vacuumsens/Final/(list of files, cad)

Other CAD files:
Client/VacuumSens V4.step
