vacuumsens/Final/VSENS.pdf

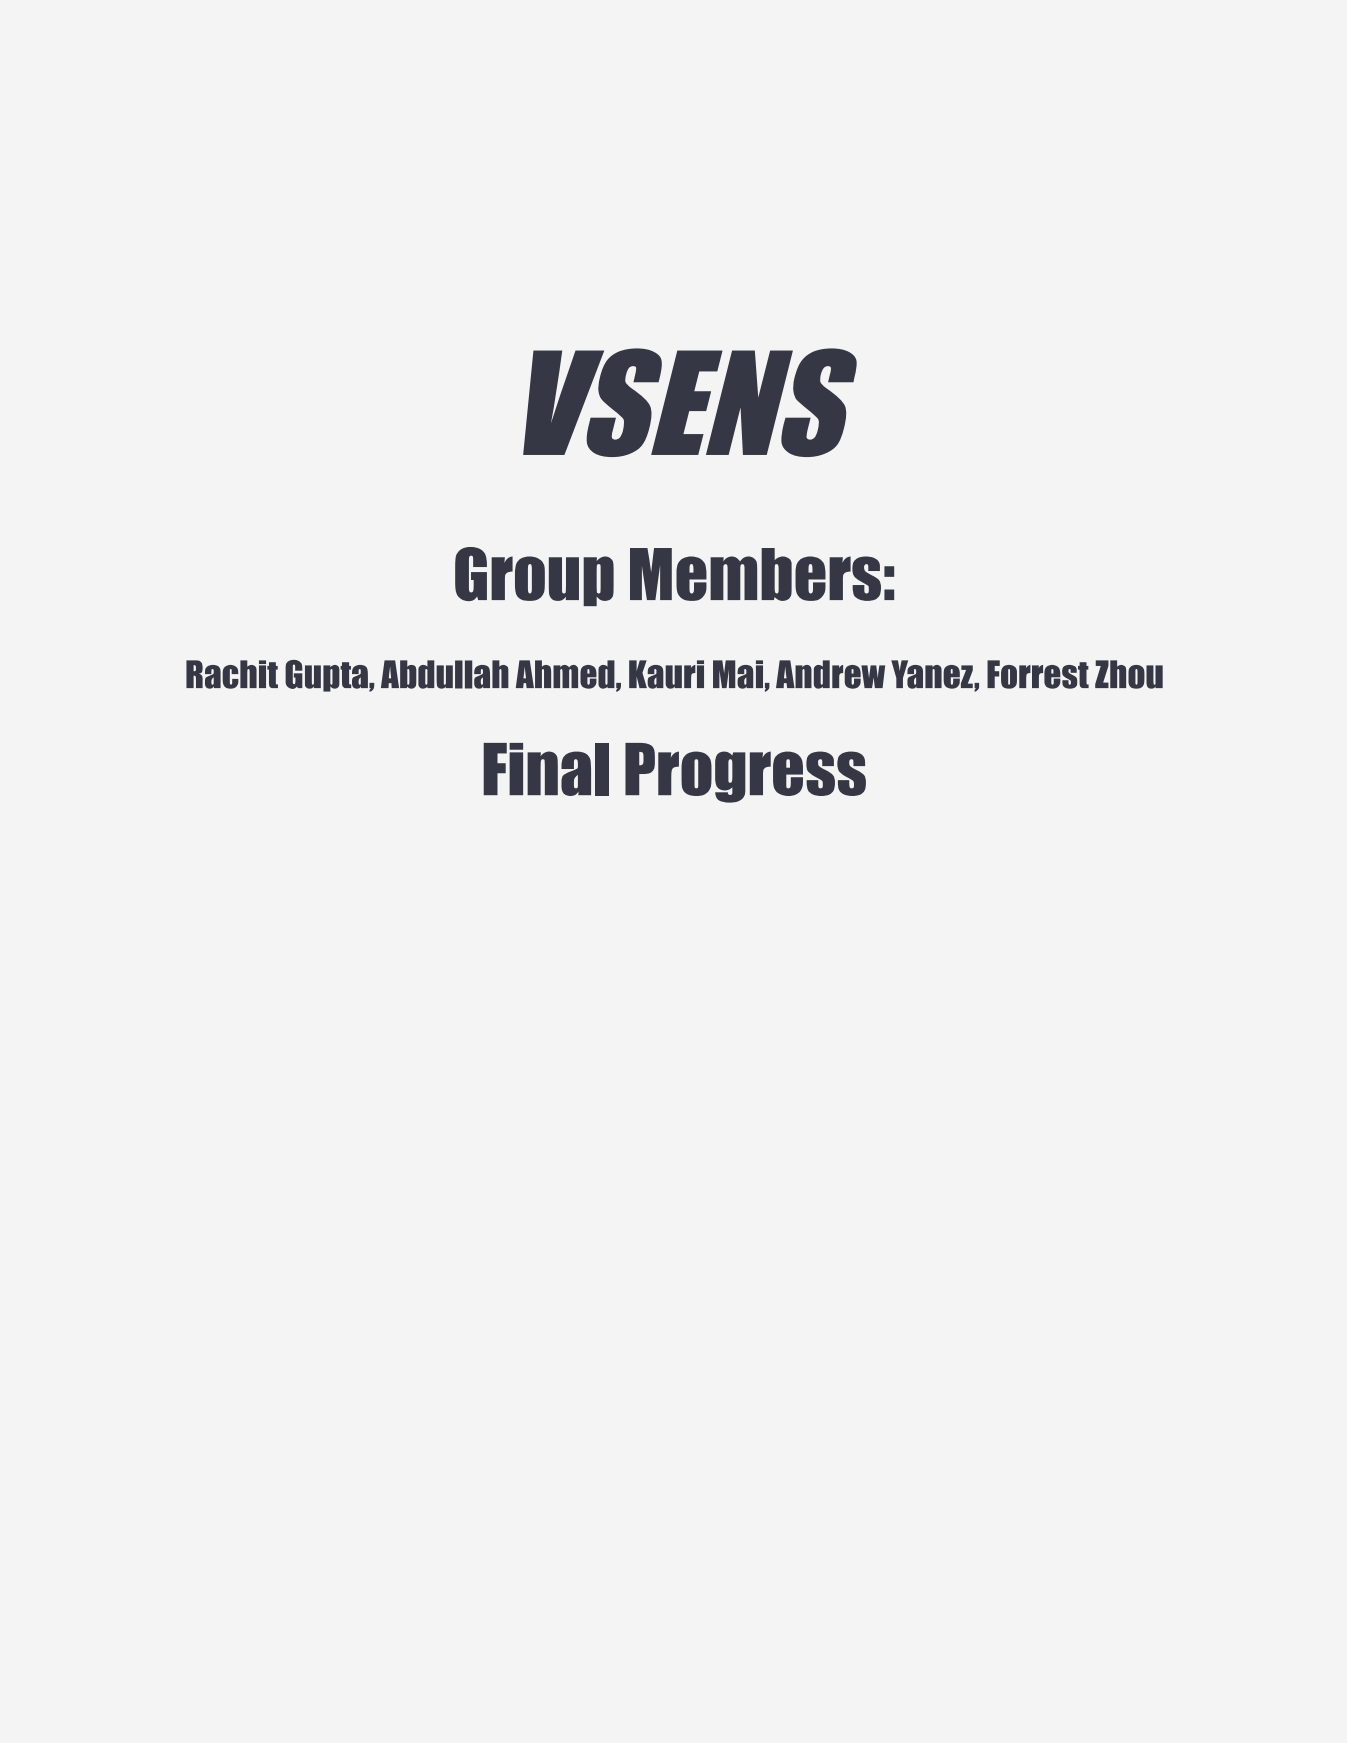
[picture p1: page 1]

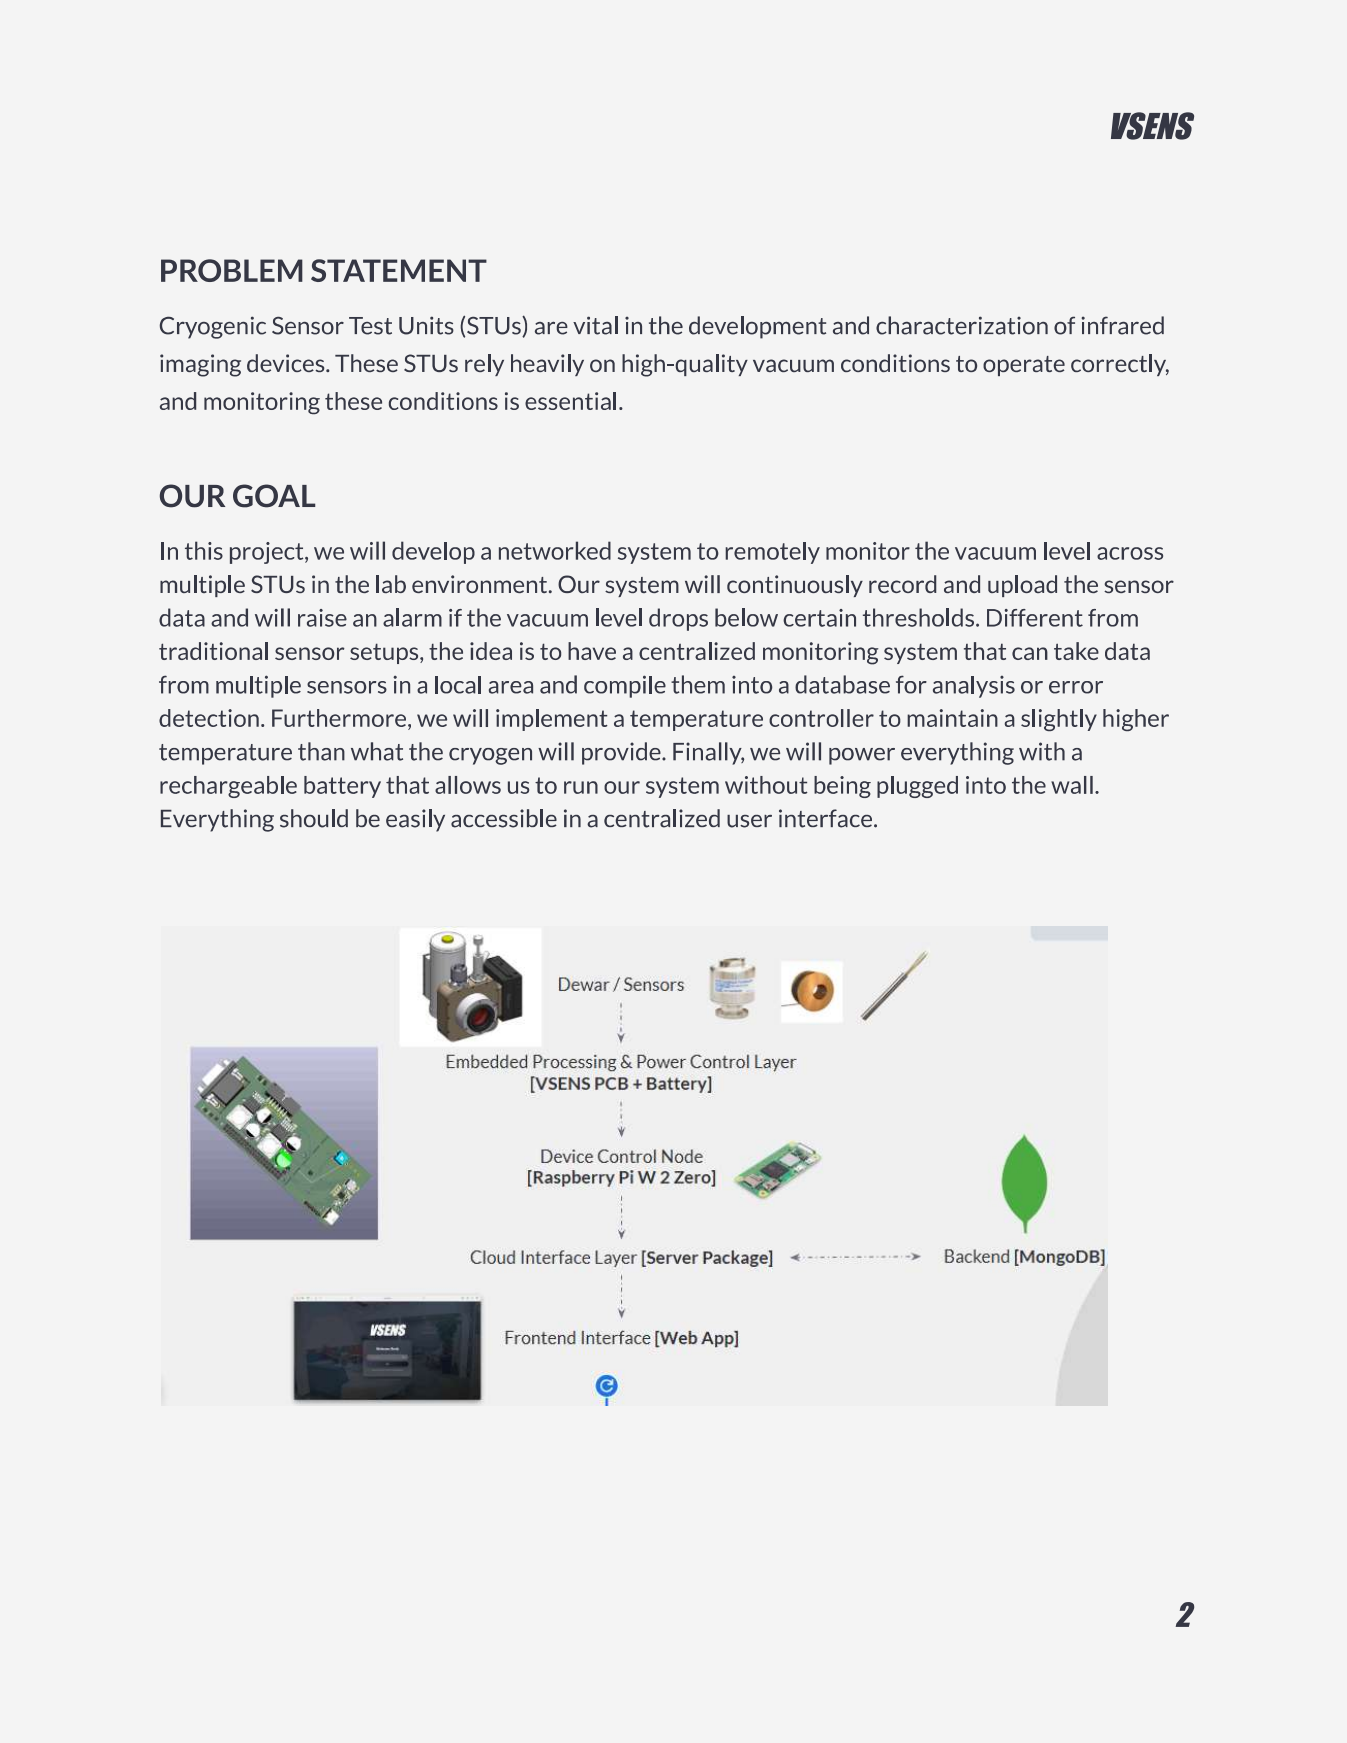
[picture p2: page 2]

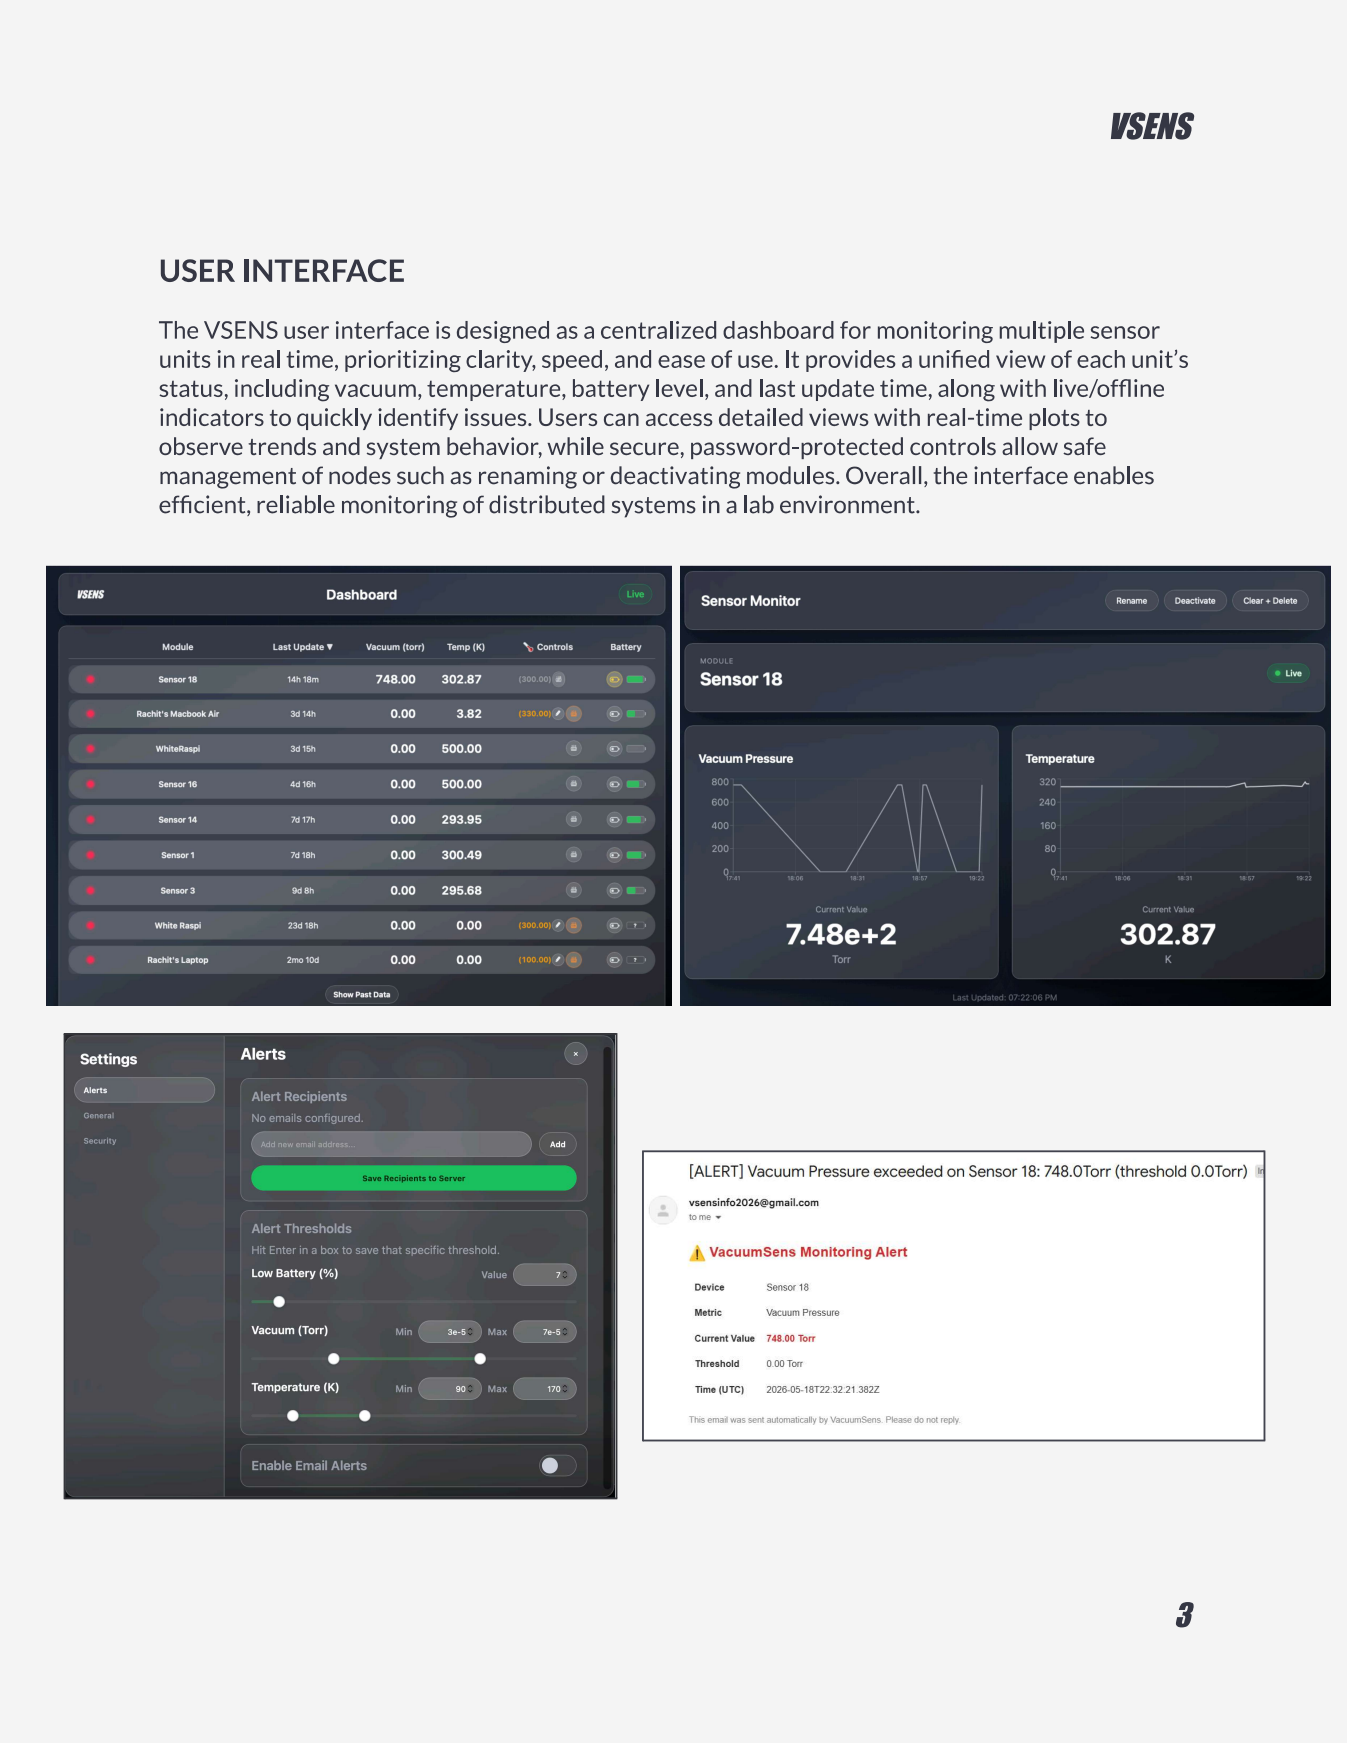
[picture p3: page 3]

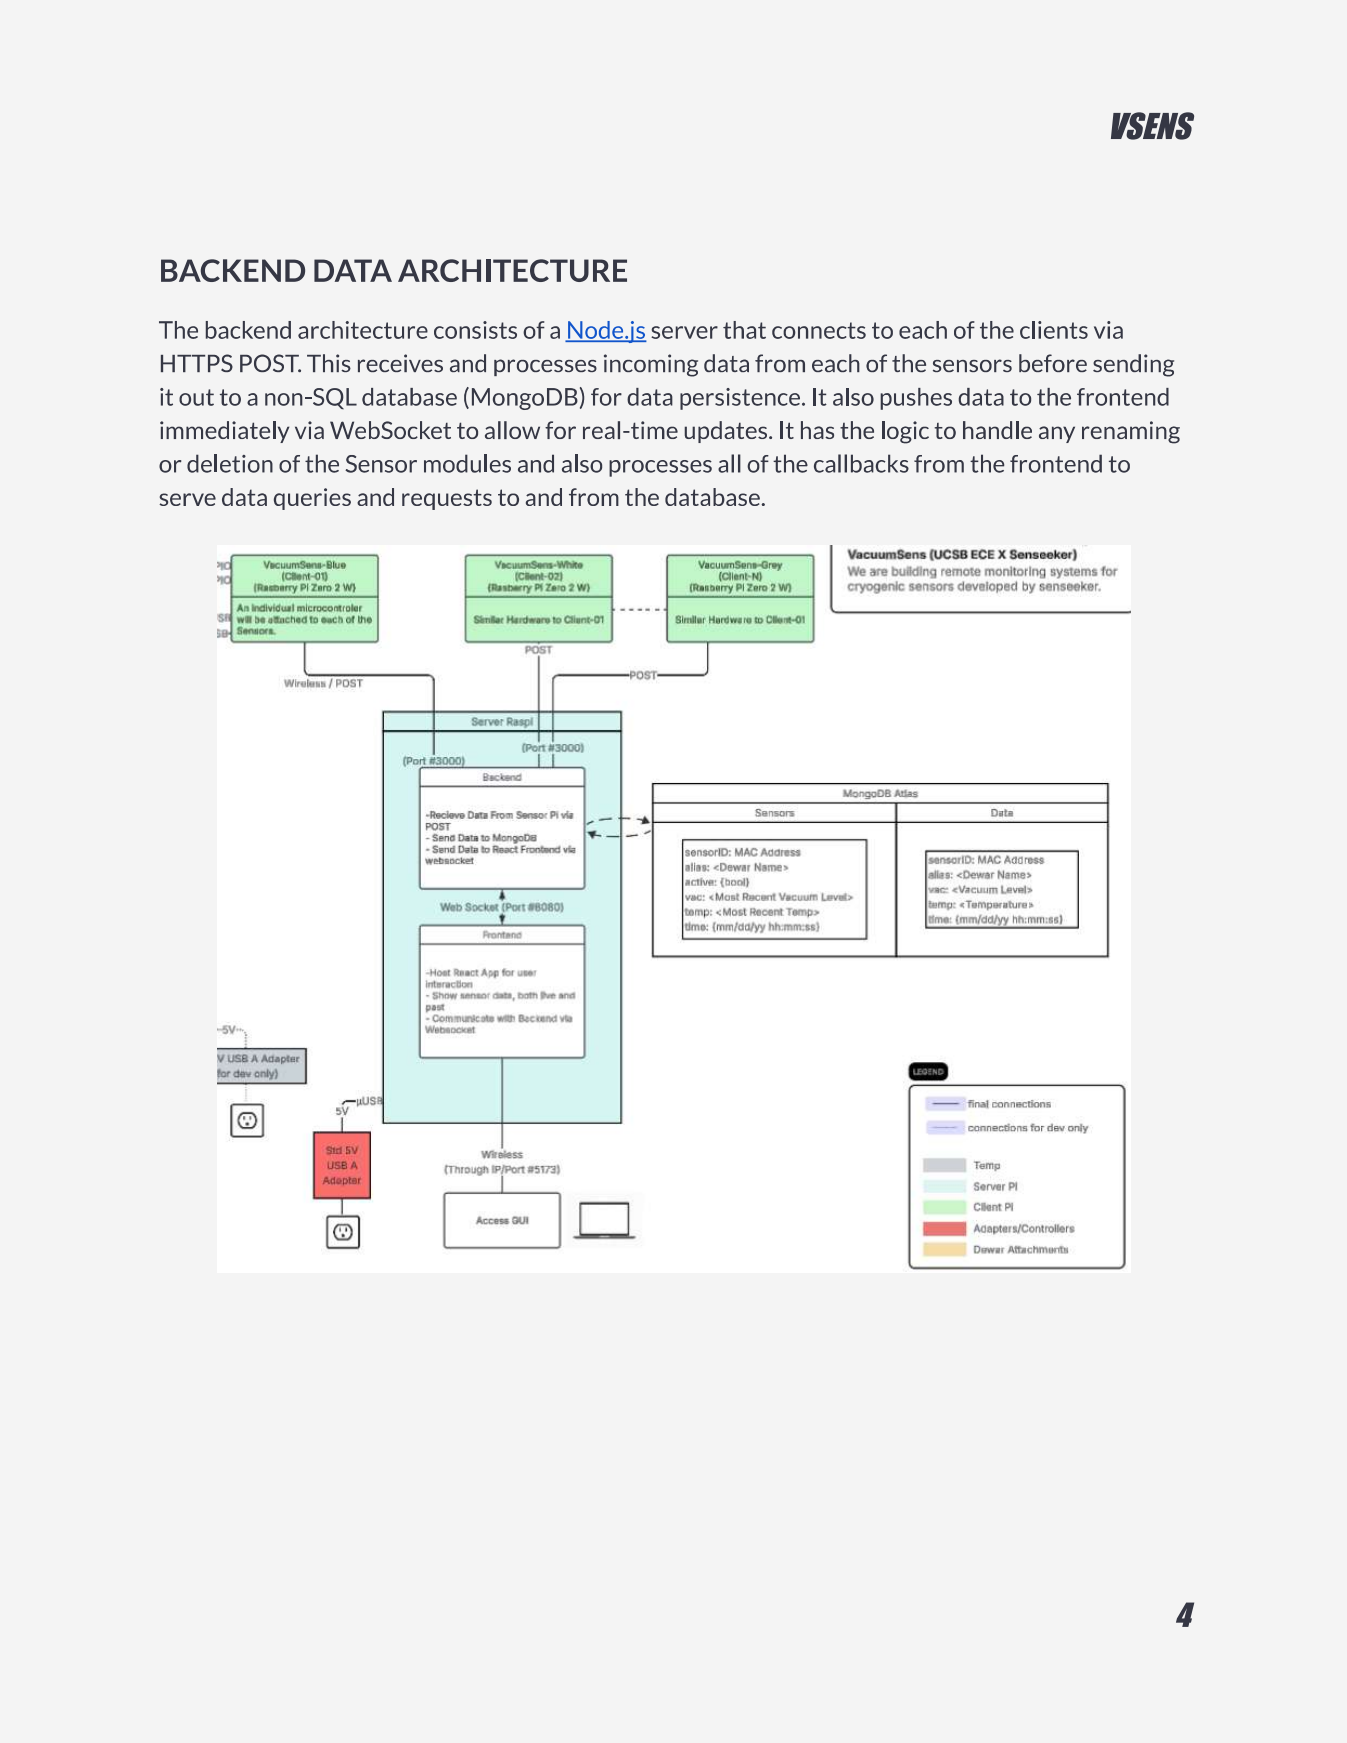
[picture p4: page 4]

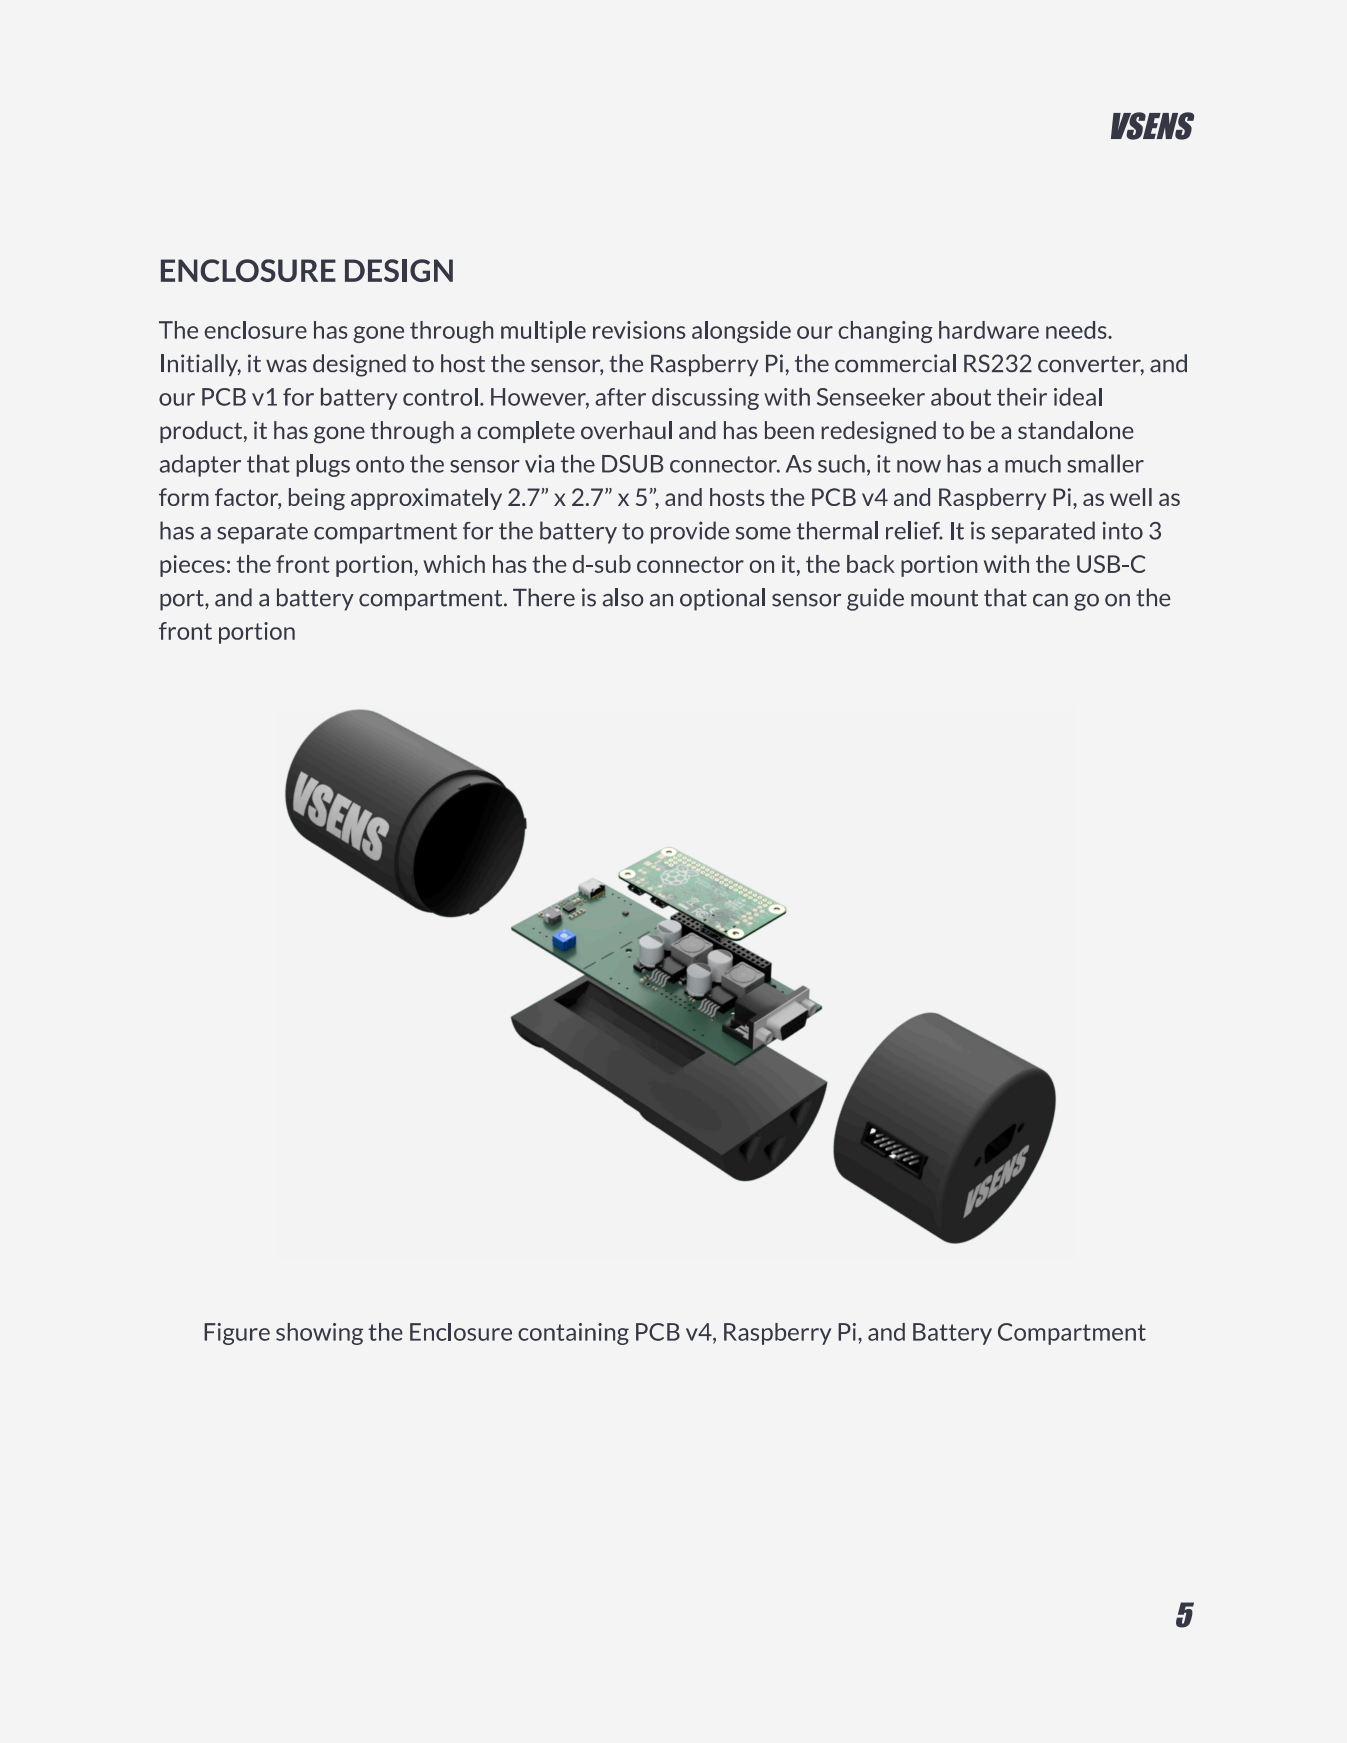
[picture p5: page 5]

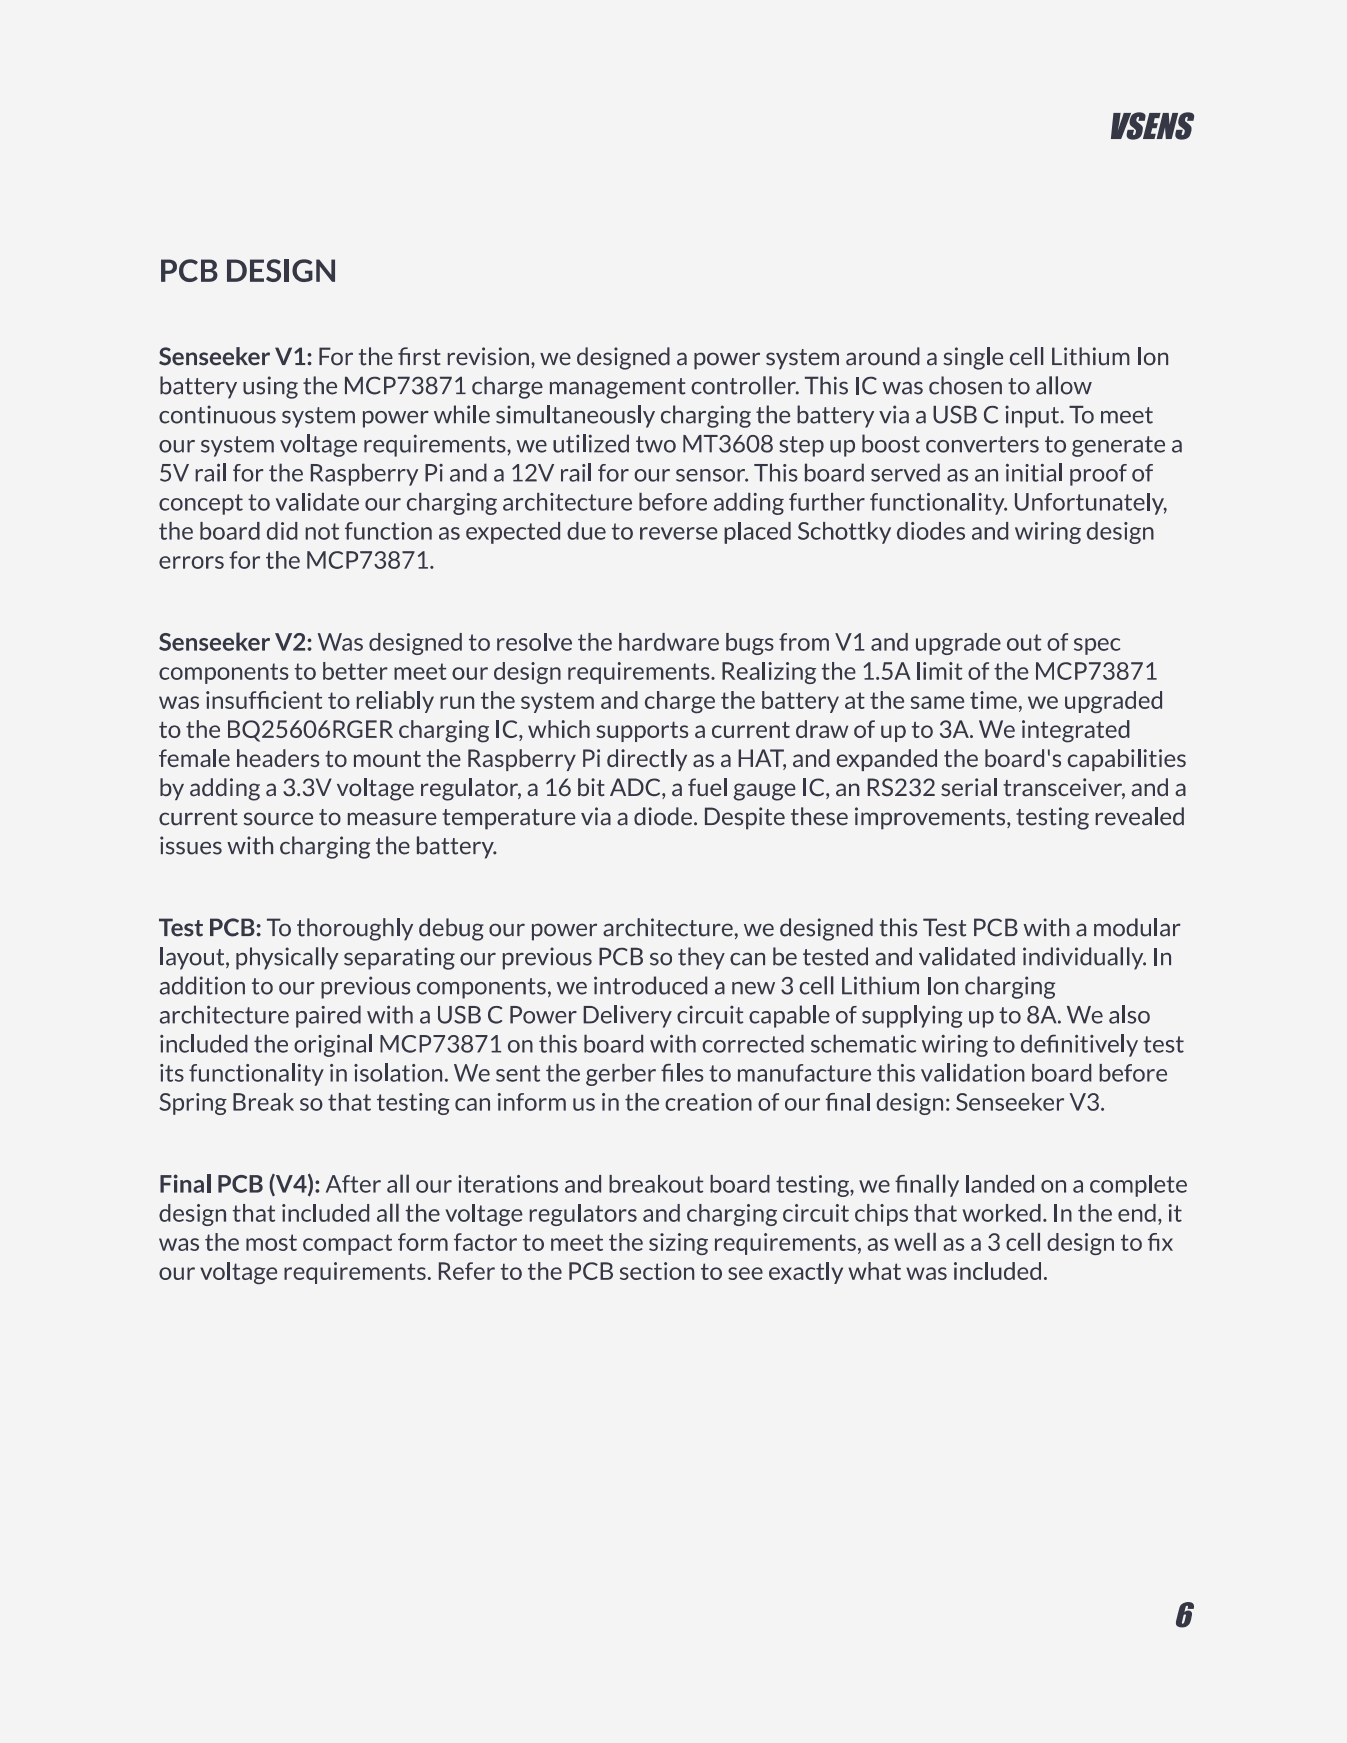
[picture p6: page 6]

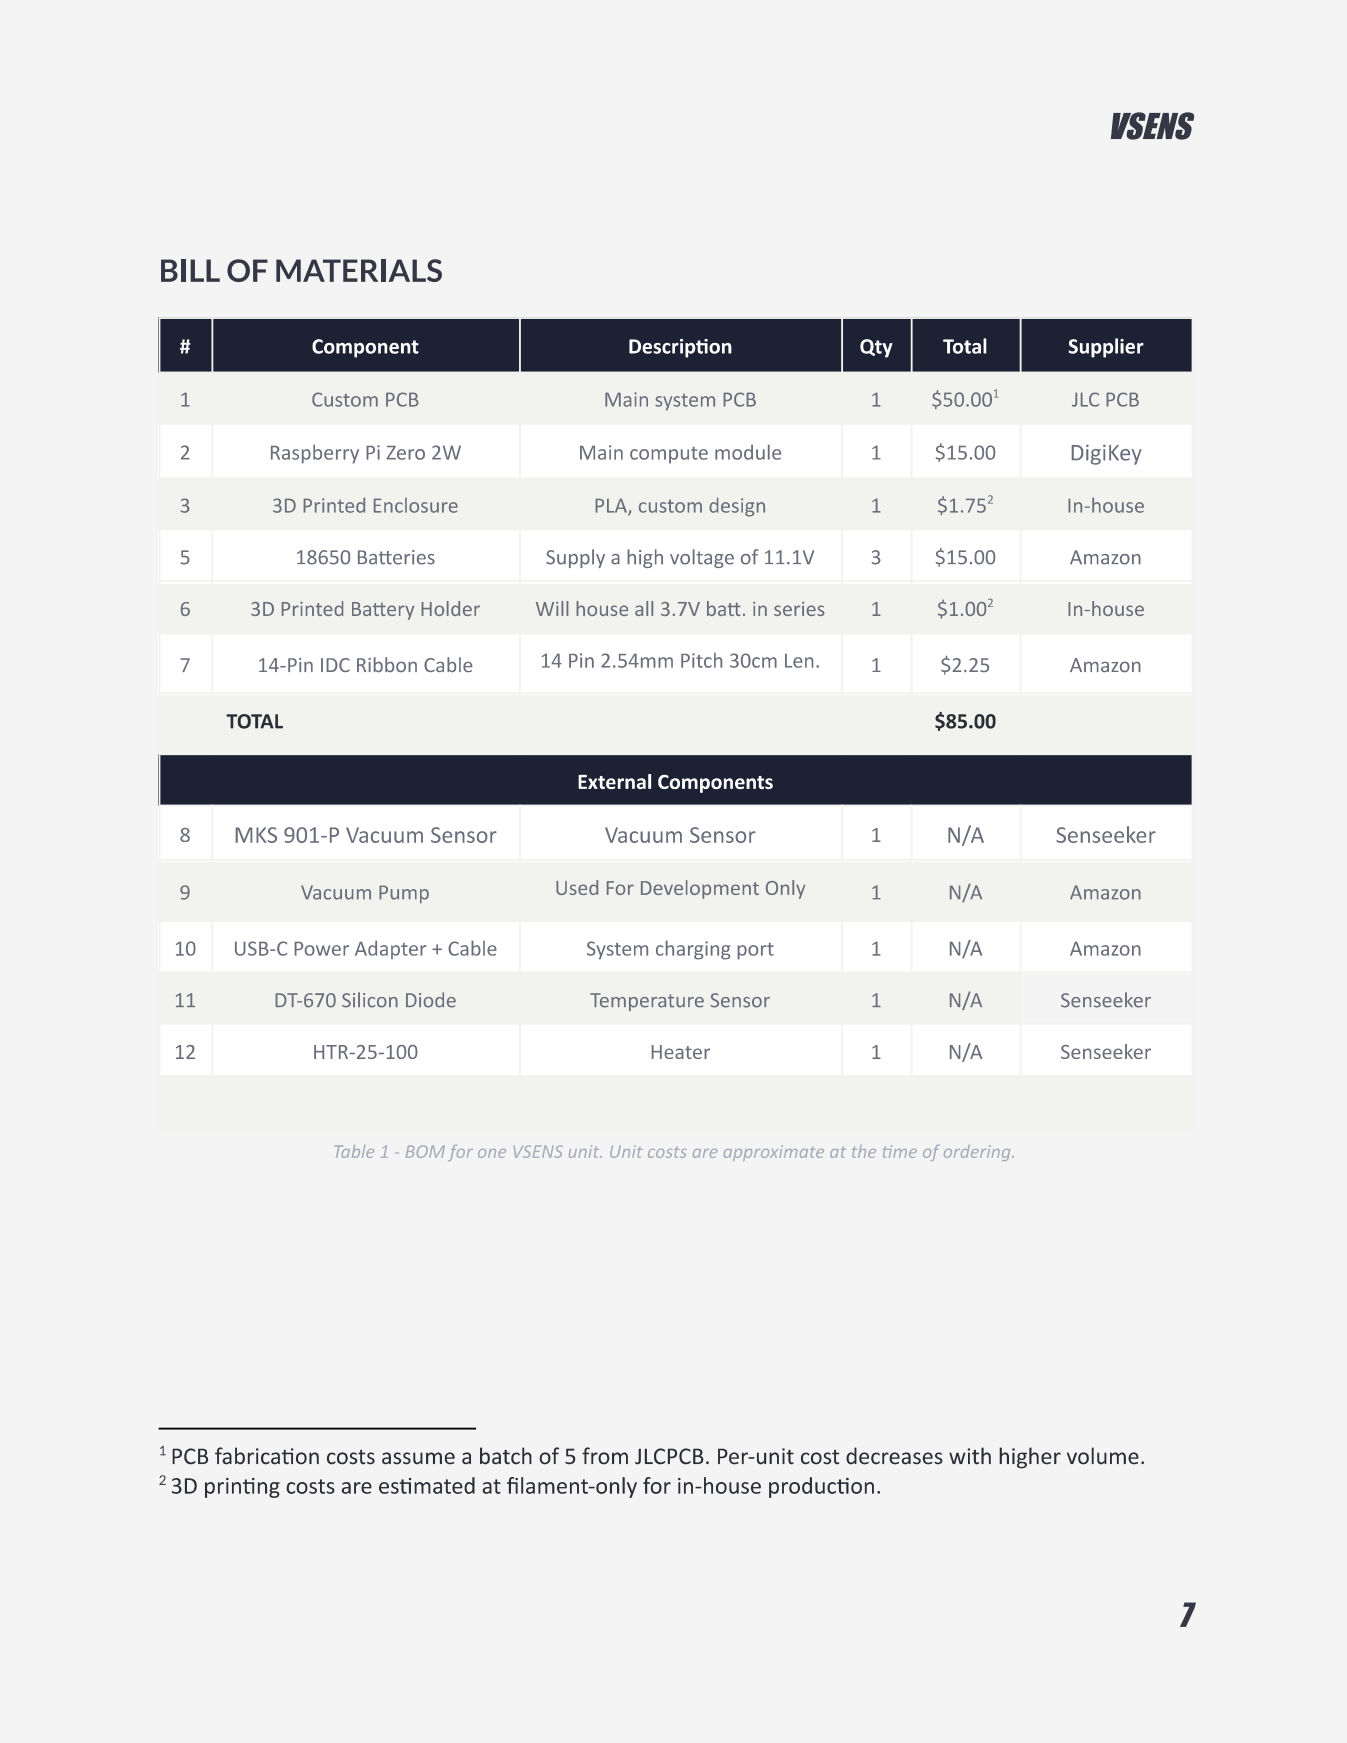
[picture p7: page 7]

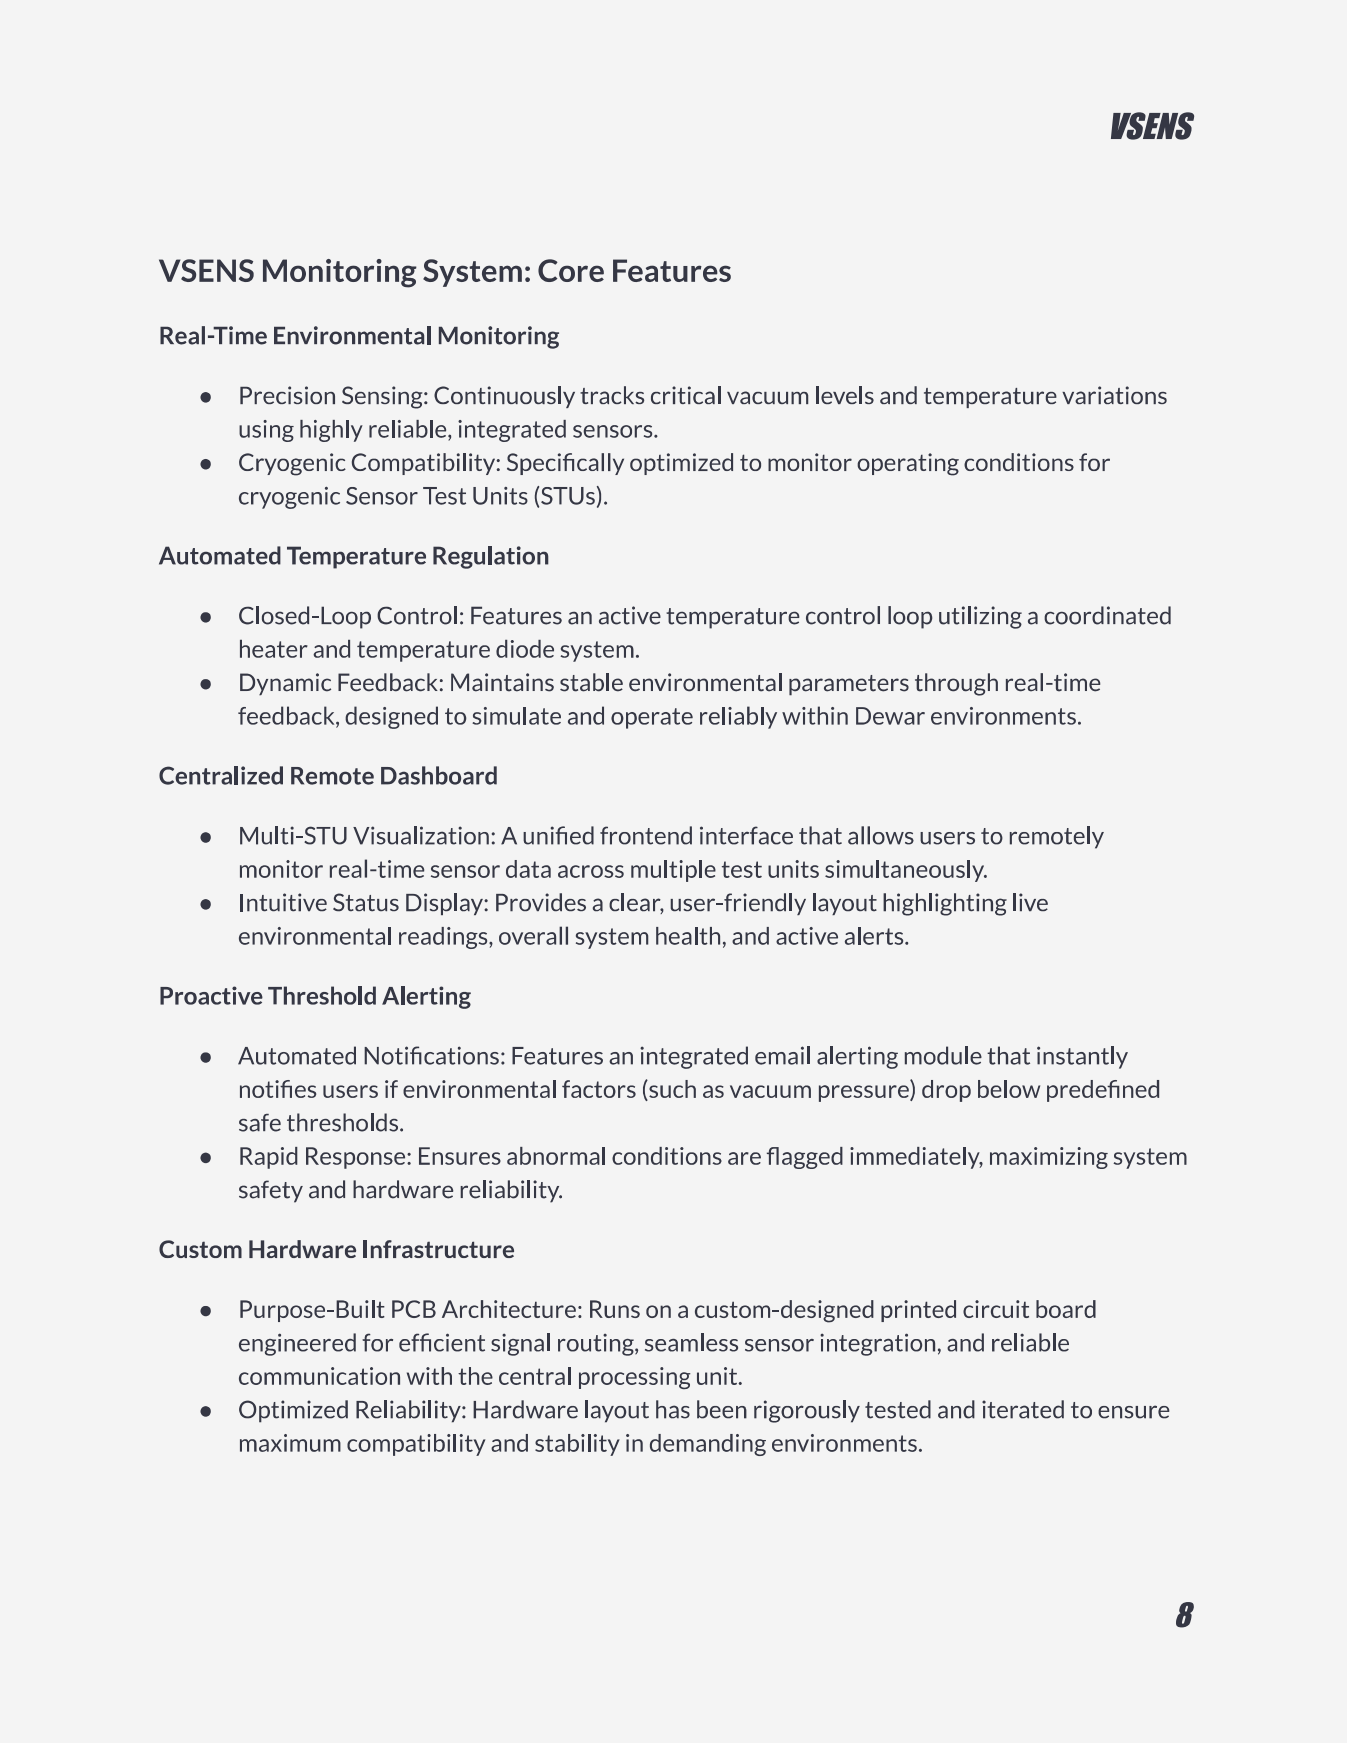
[picture p8: page 8]

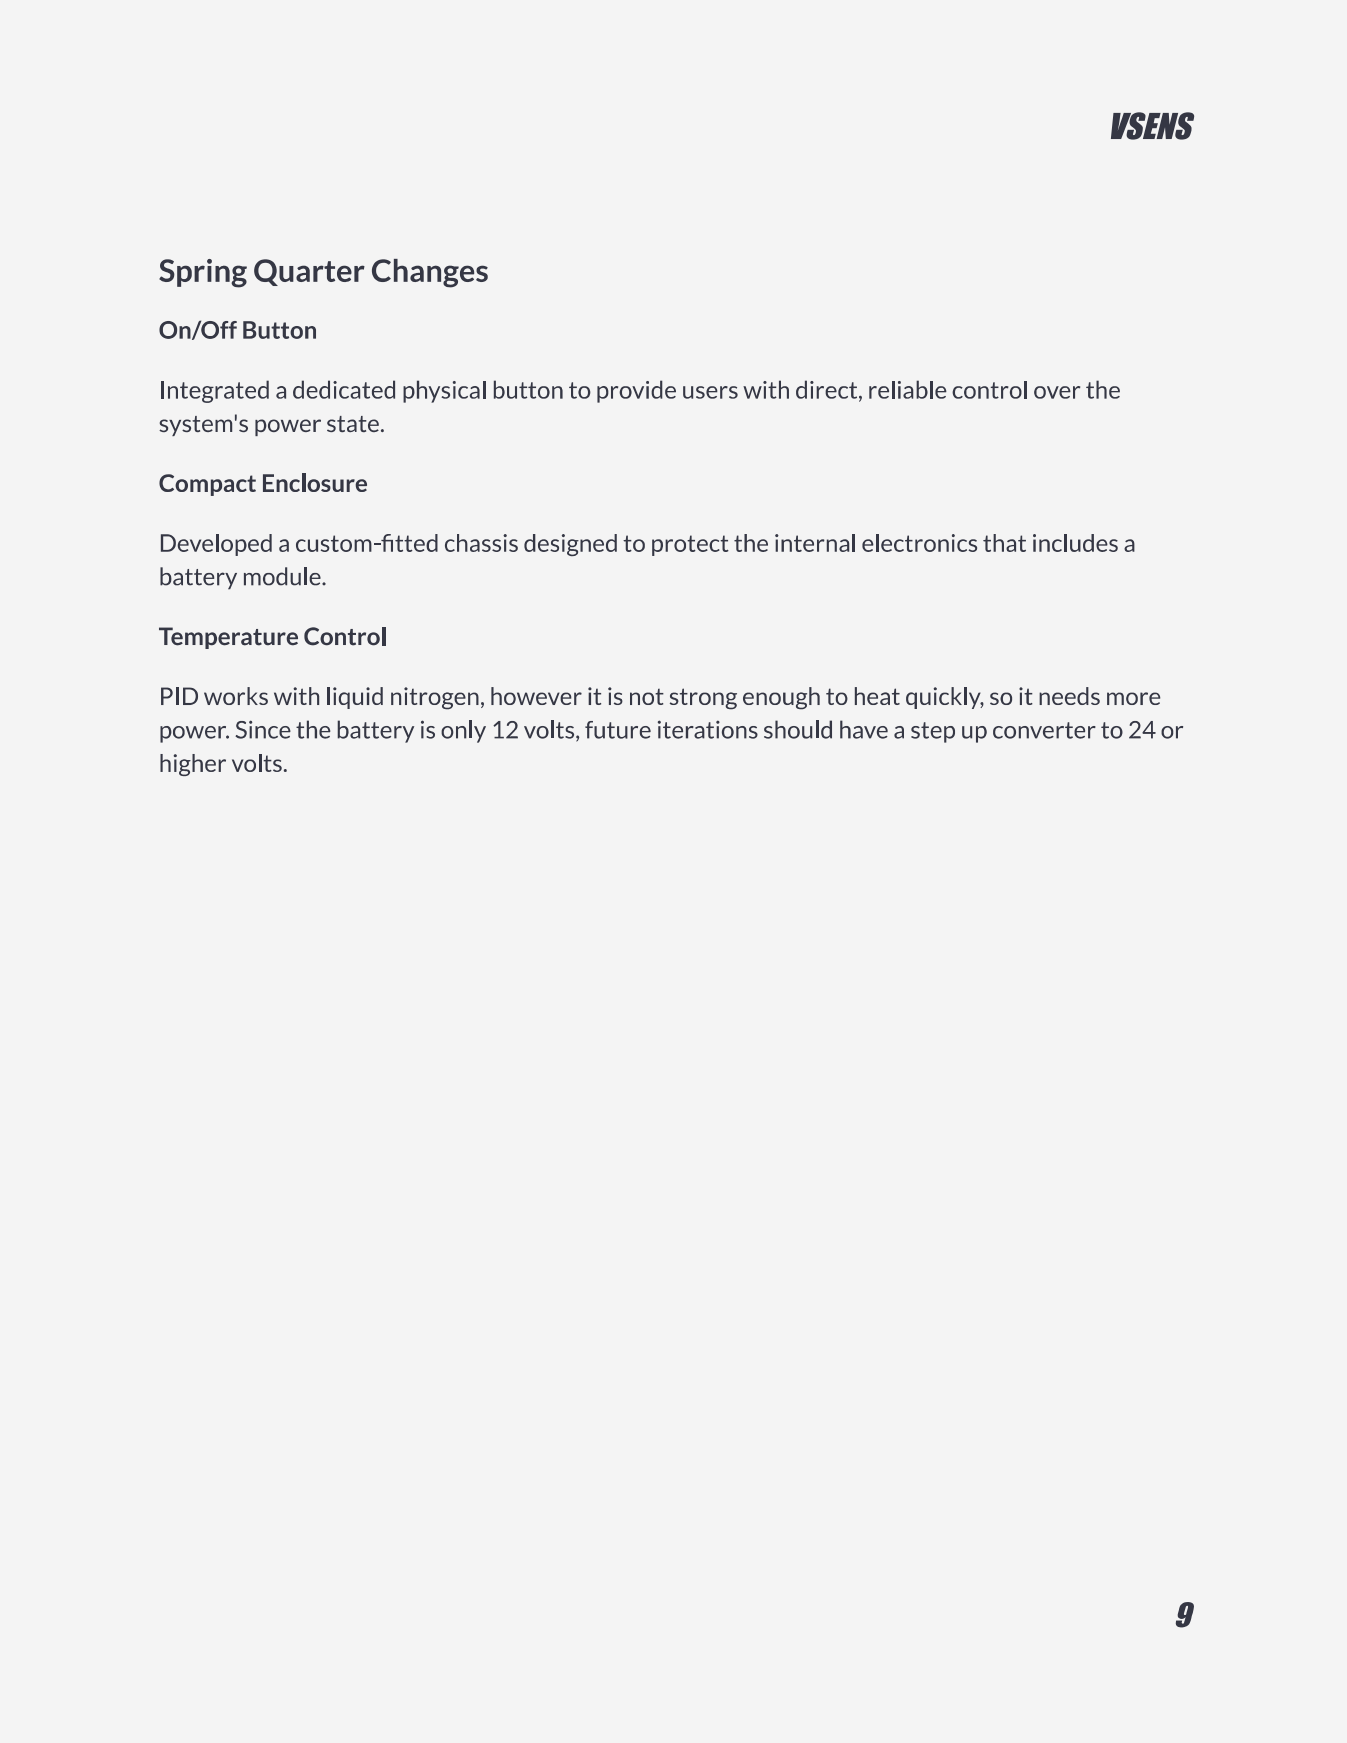
[picture p9: page 9]

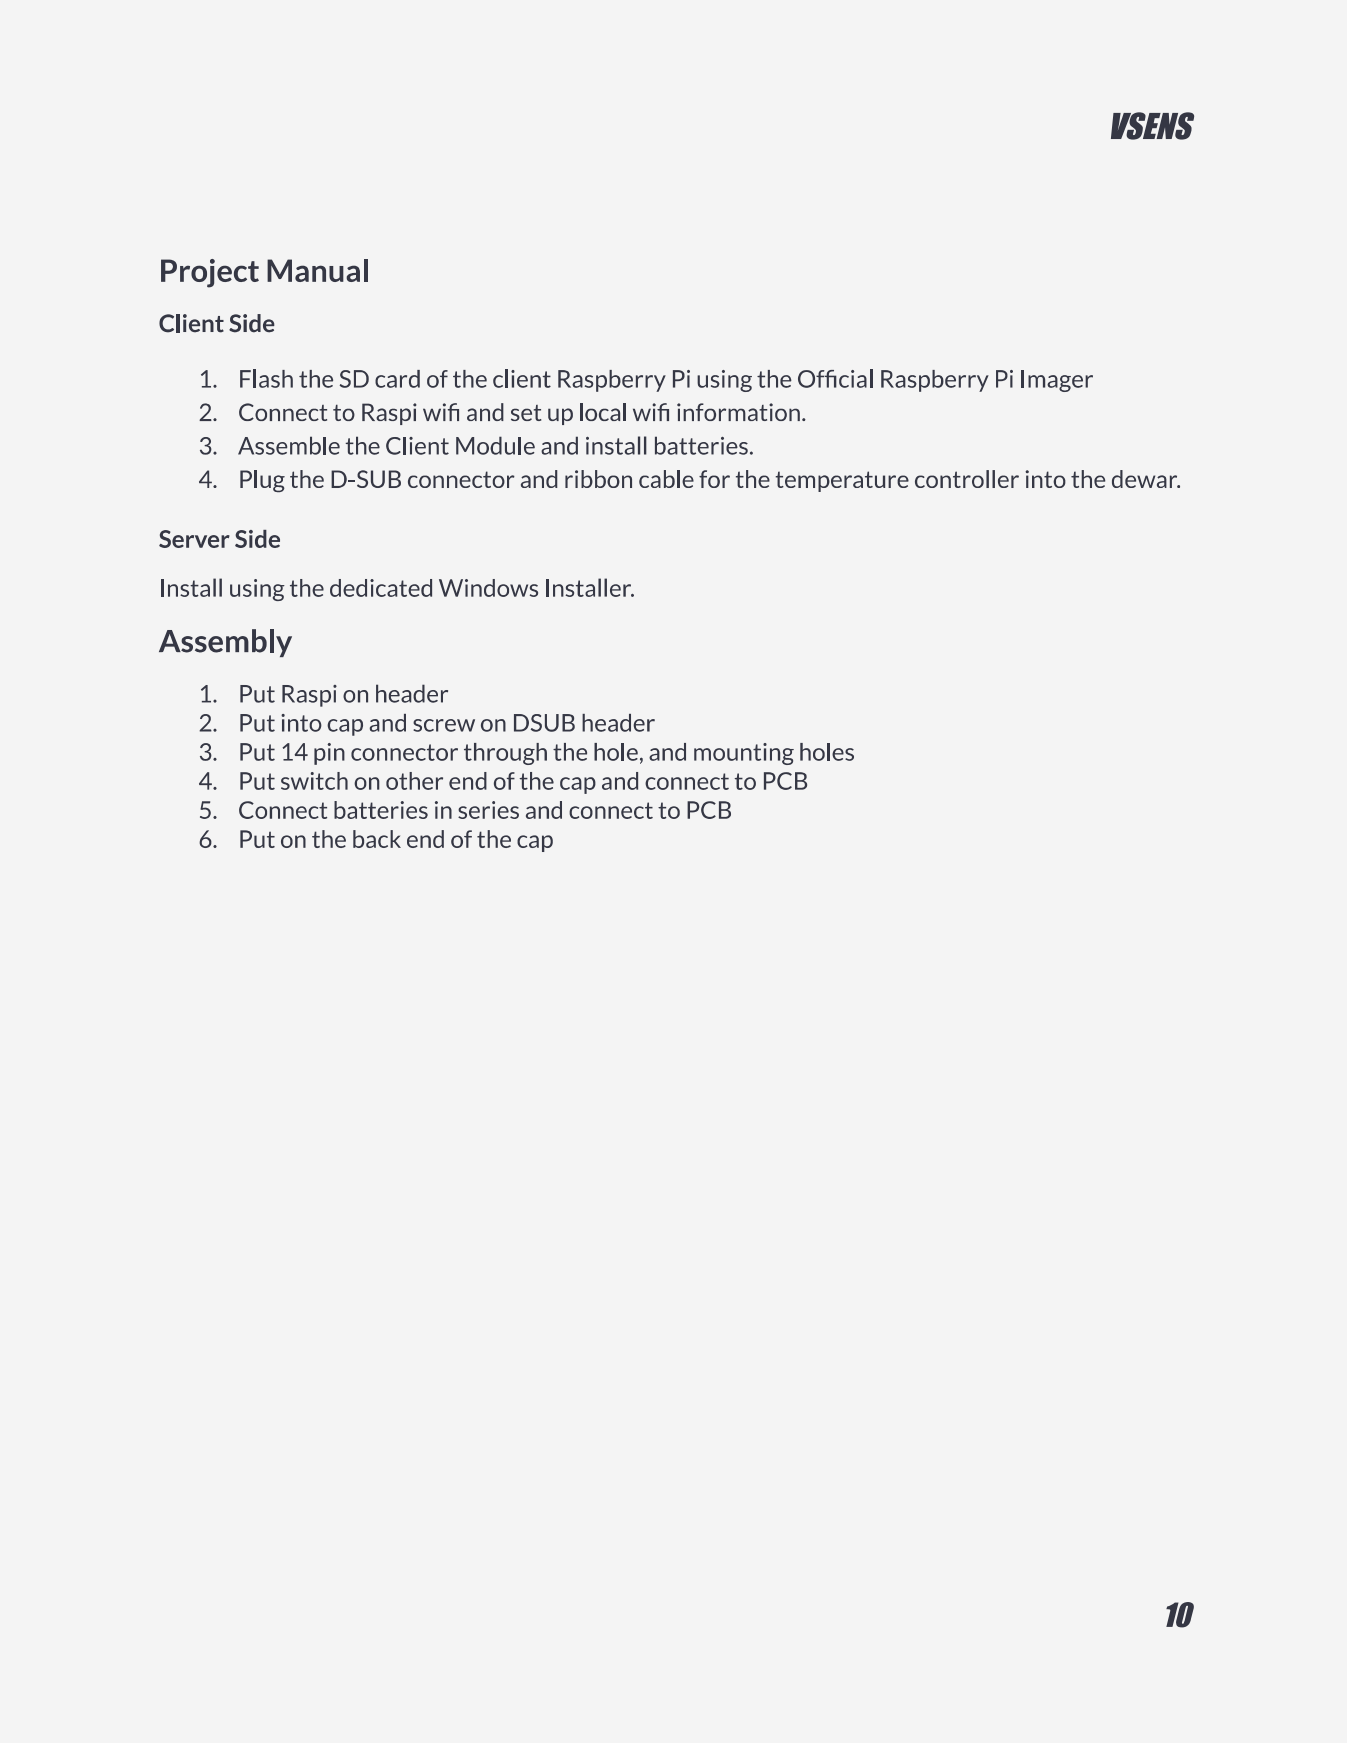
[picture p10: page 10]

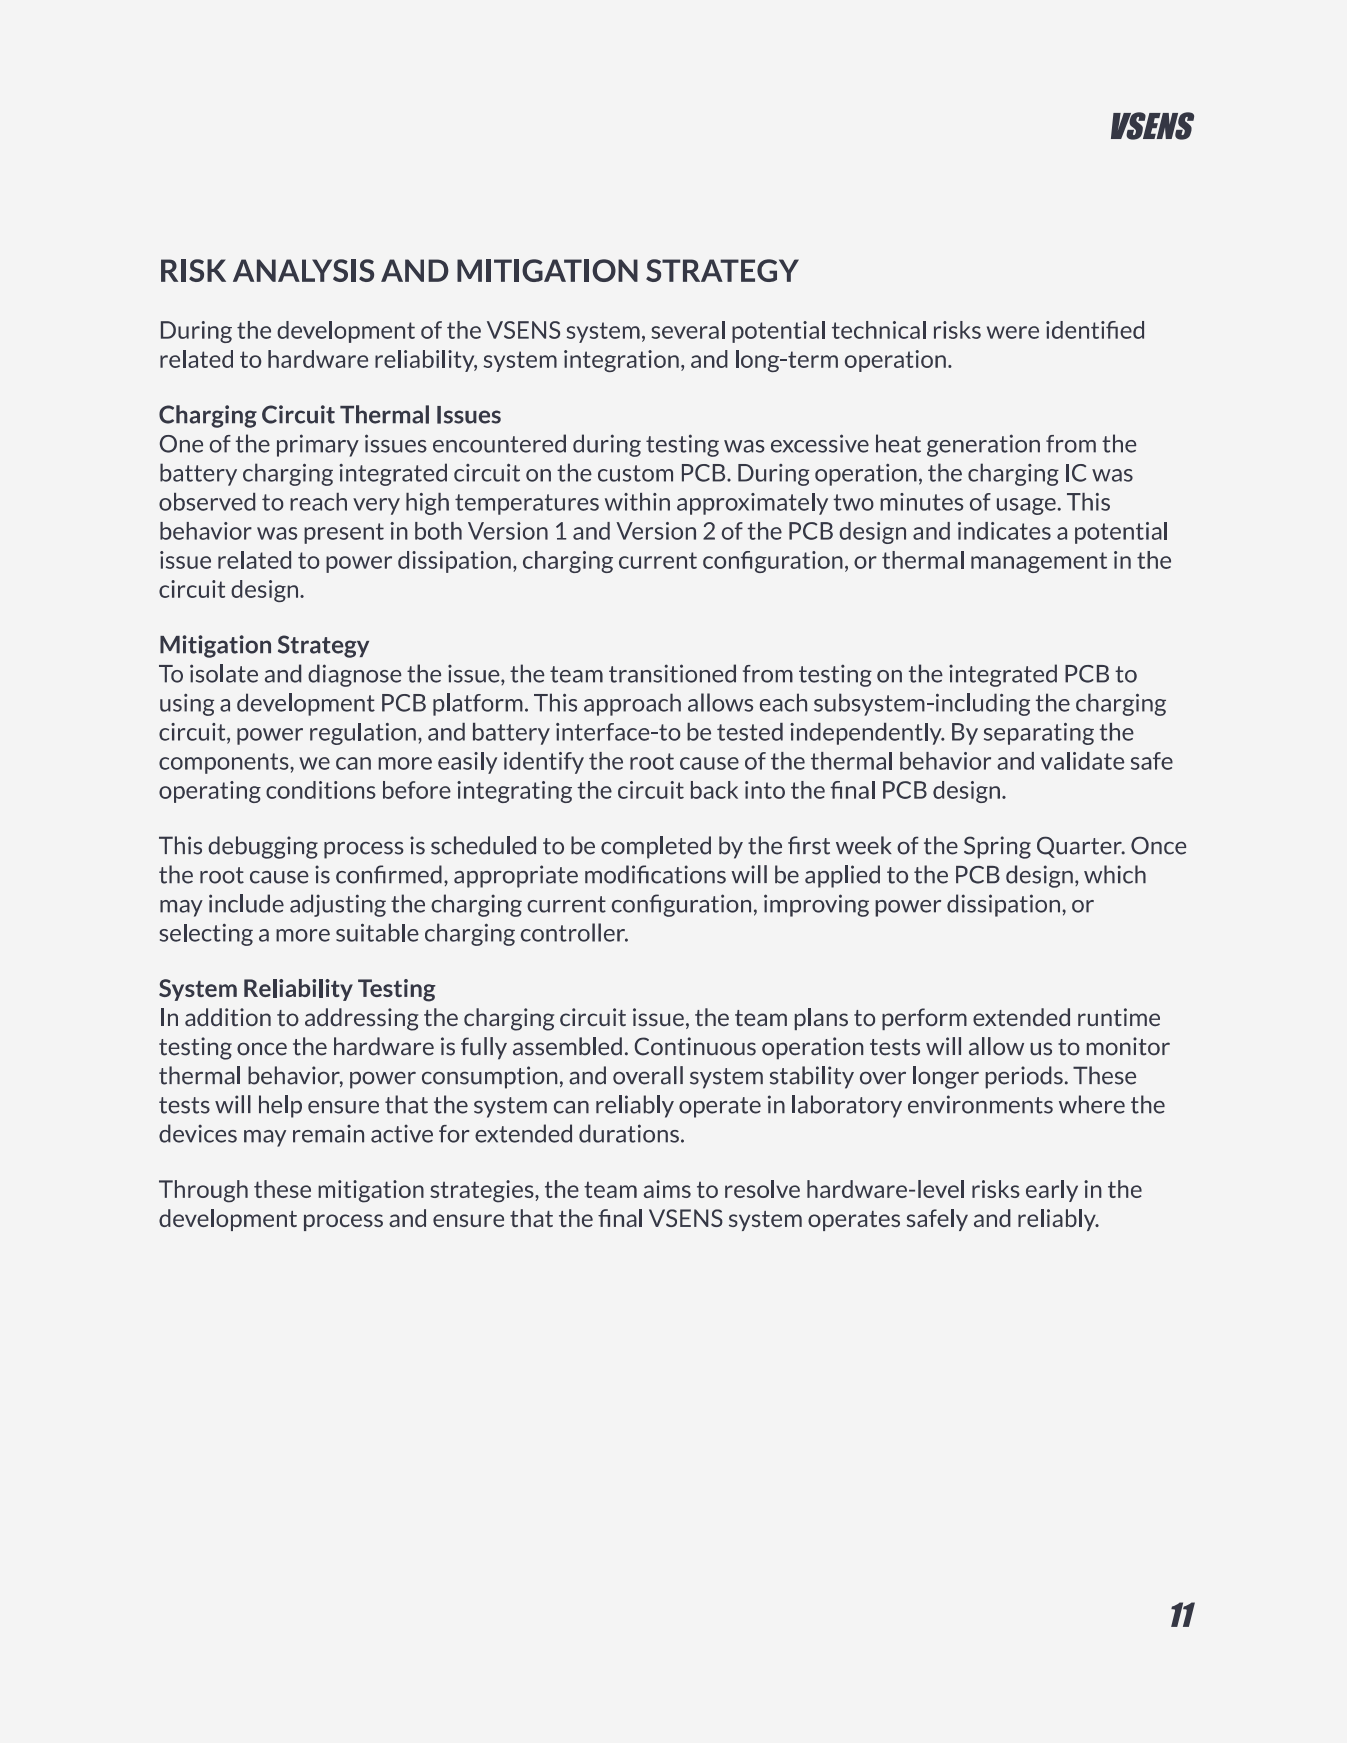
[picture p11: page 11]

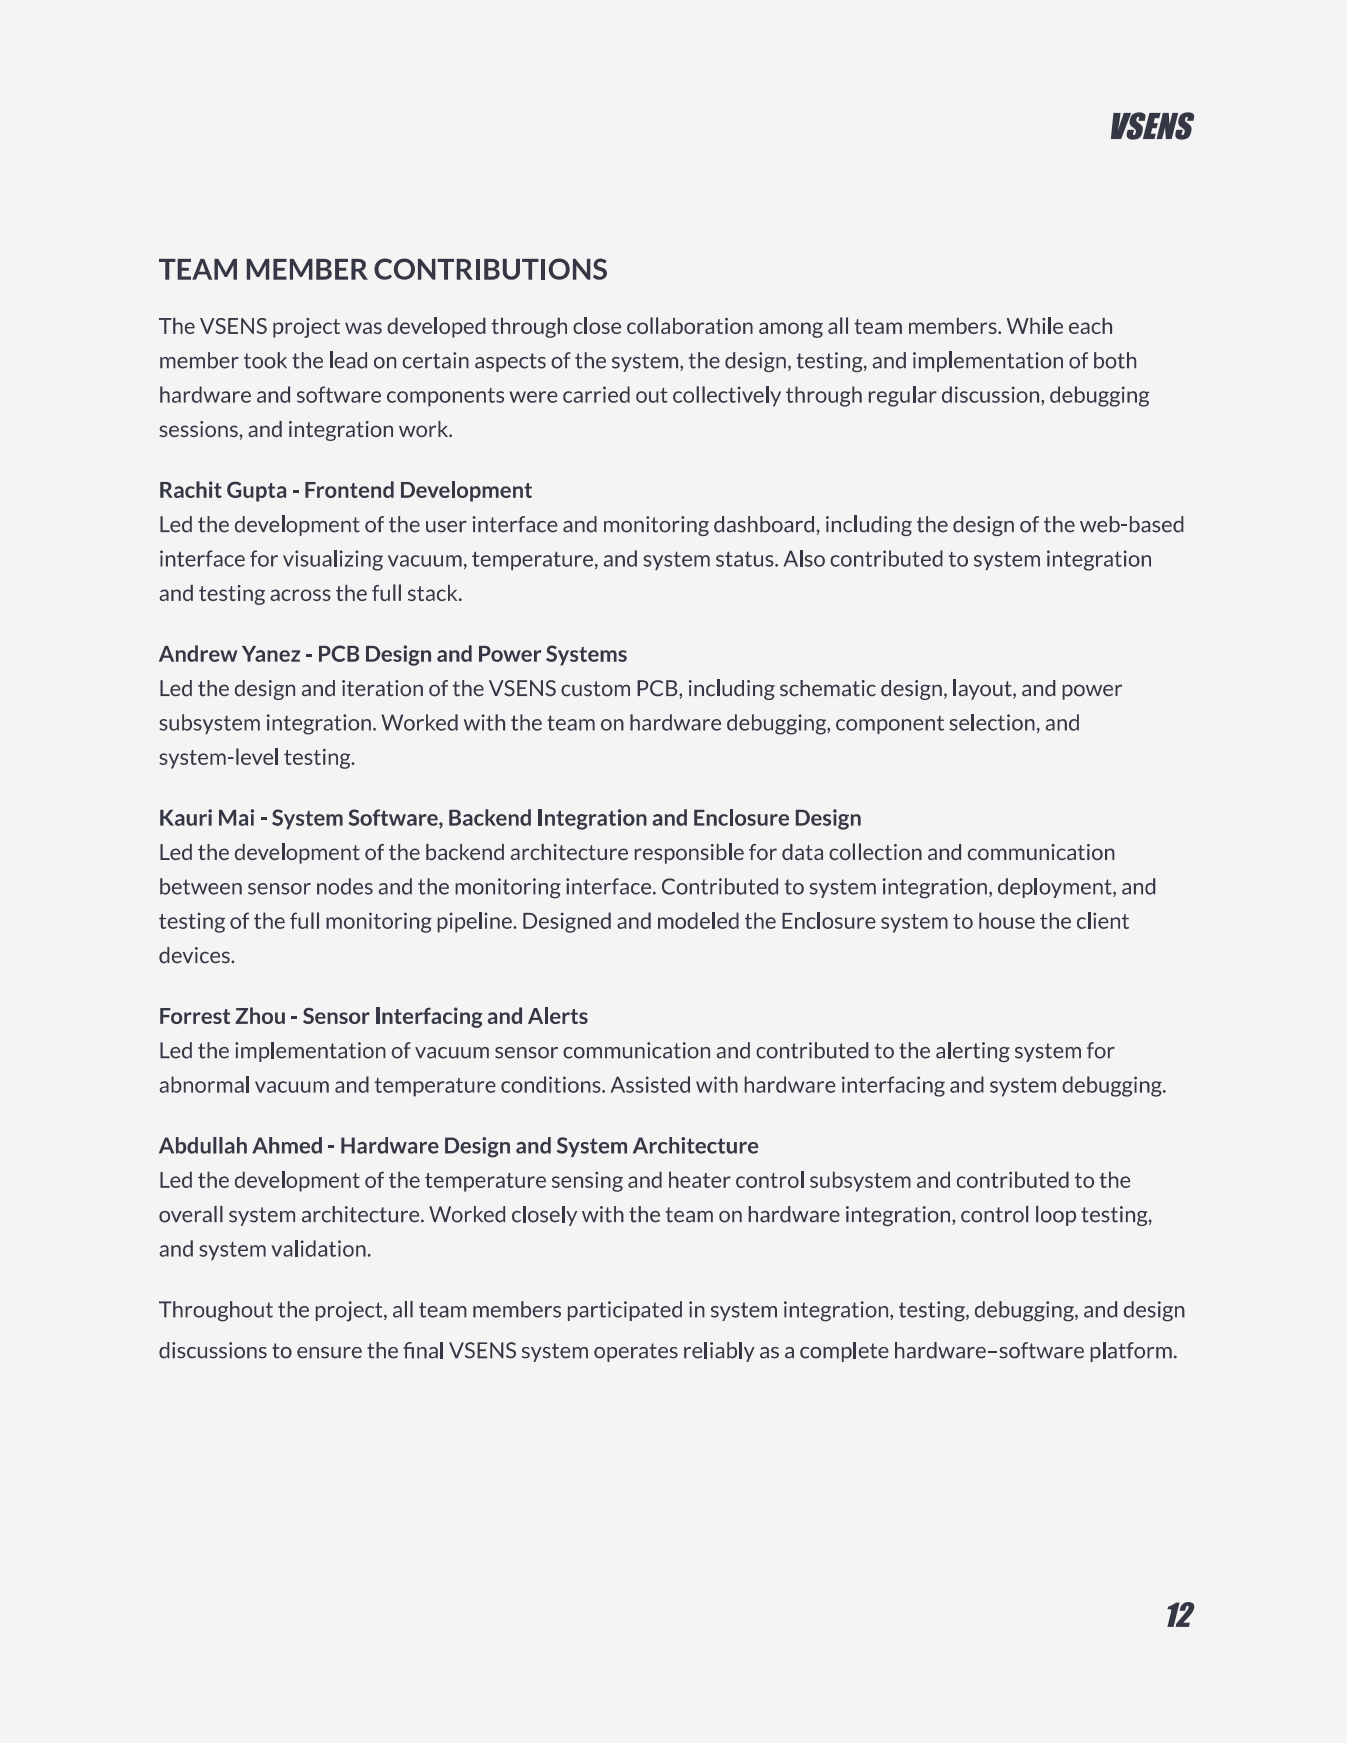
[picture p12: page 12]

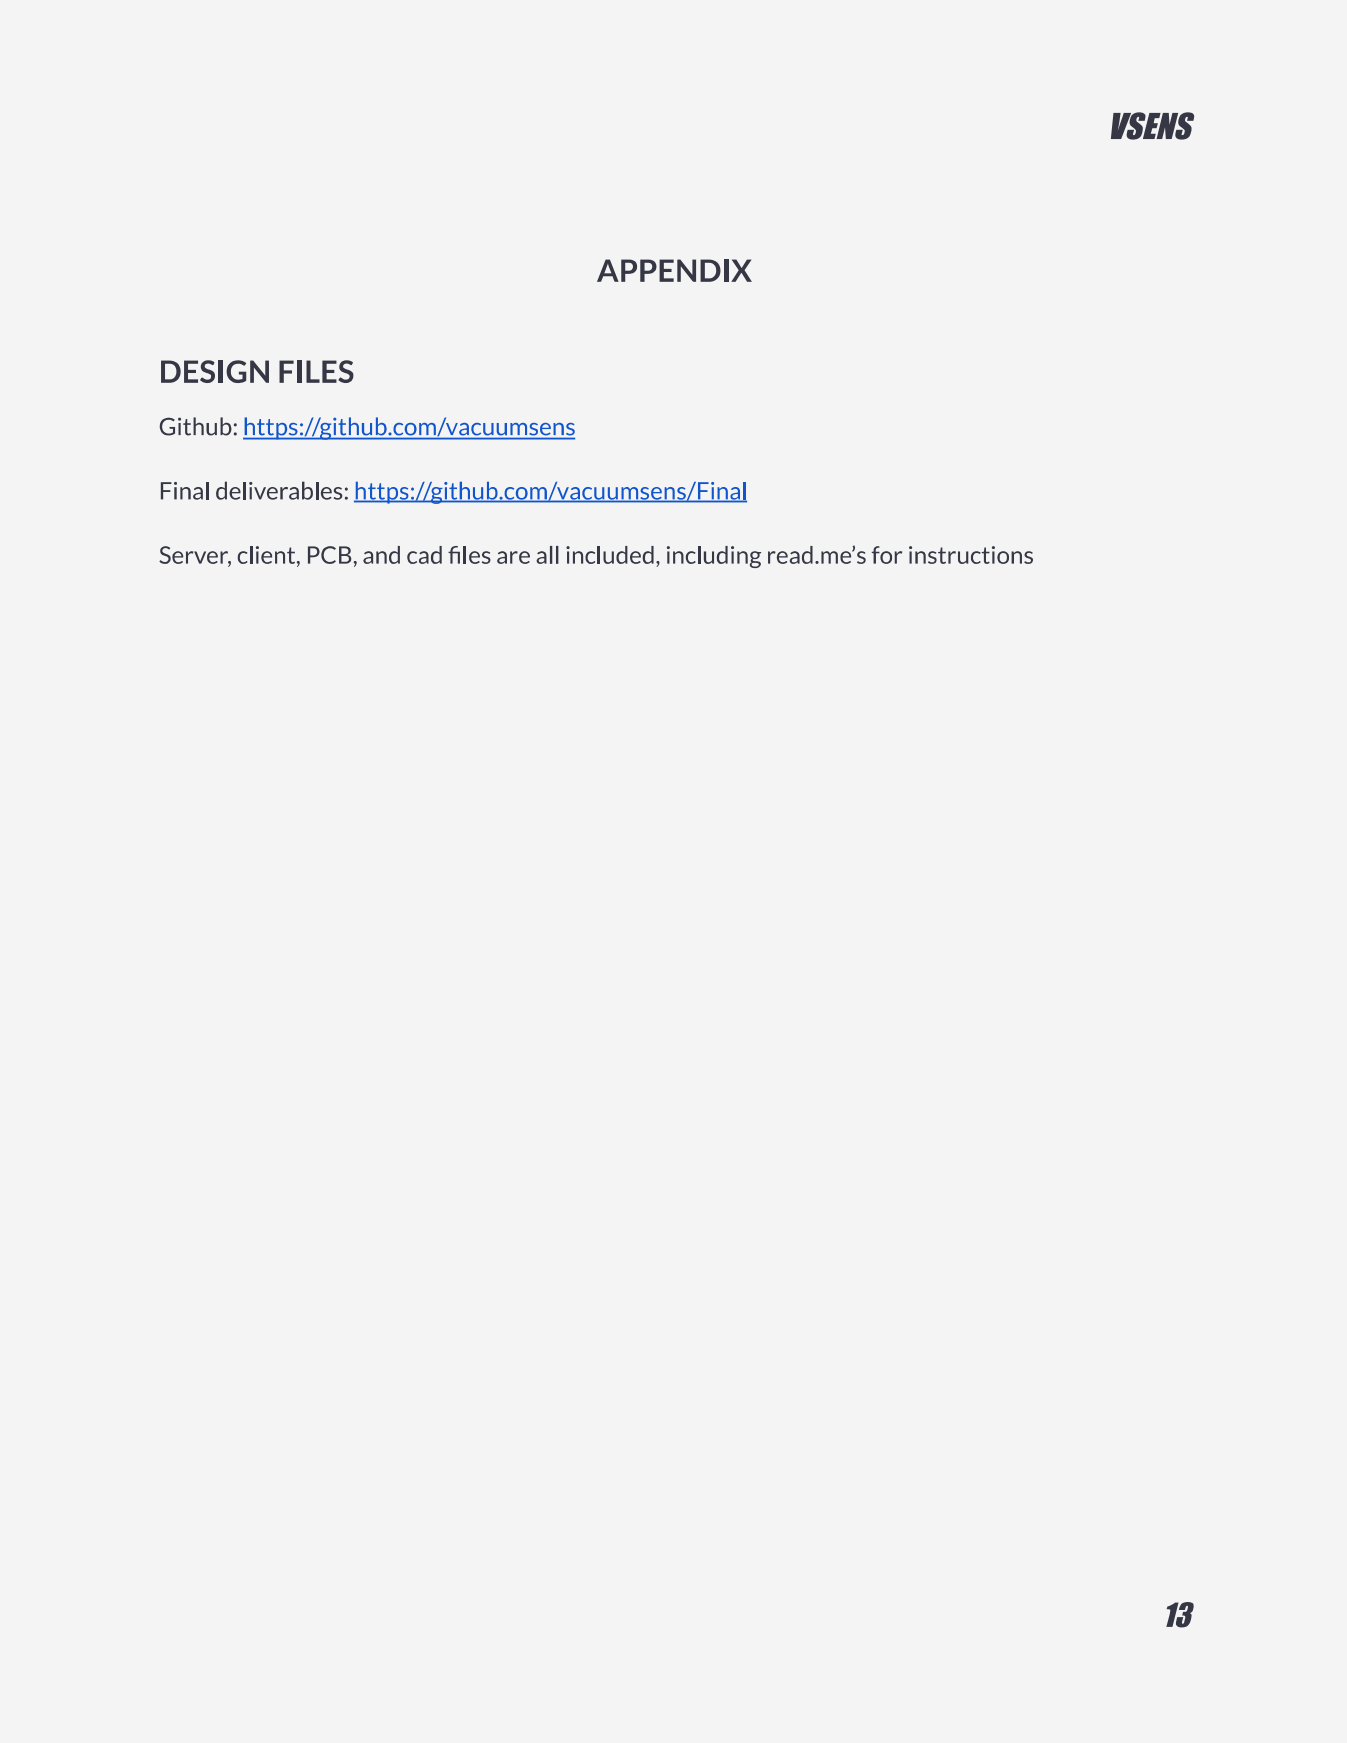
[picture p13: page 13]
