vacuumsens/Final/PCB/charging-circuit/charging-circuit.kicad_pcb

## KiCad design PCB/charging-circuit/charging-circuit.kicad_pcb (2026-06-02)

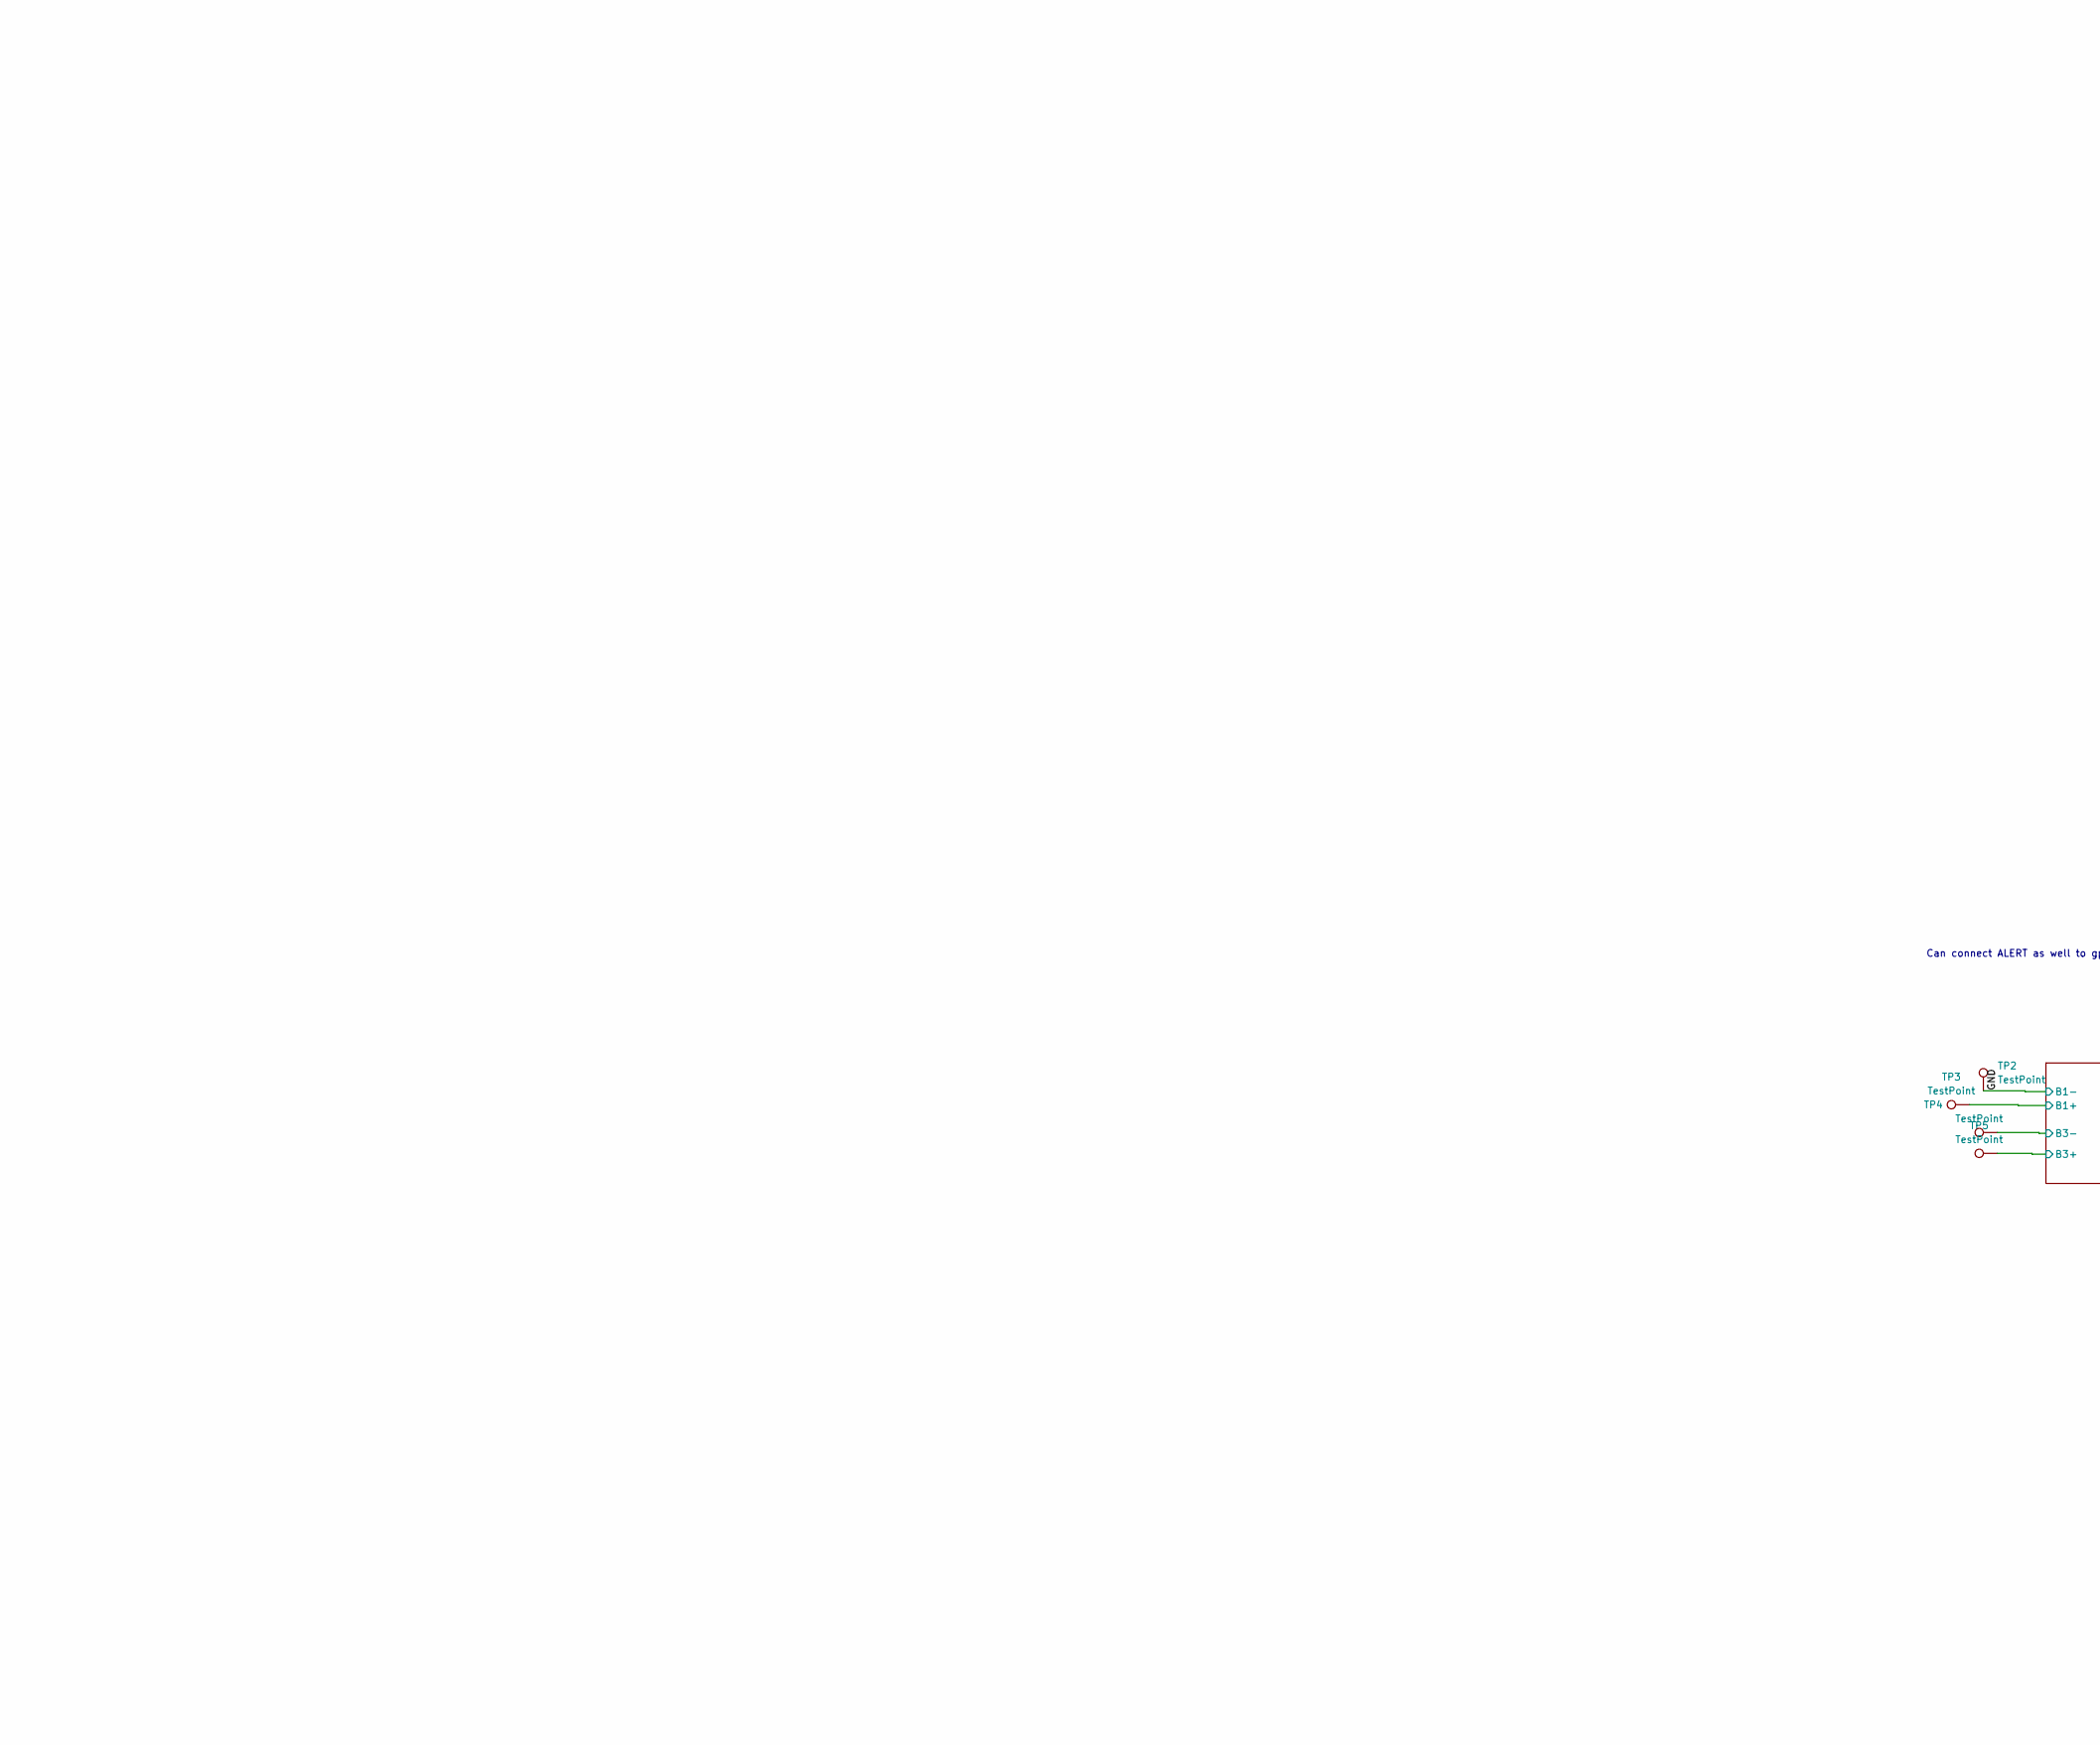
[picture p14: schematic charging-circuit.kicad_sch, part in row 2, column 1]

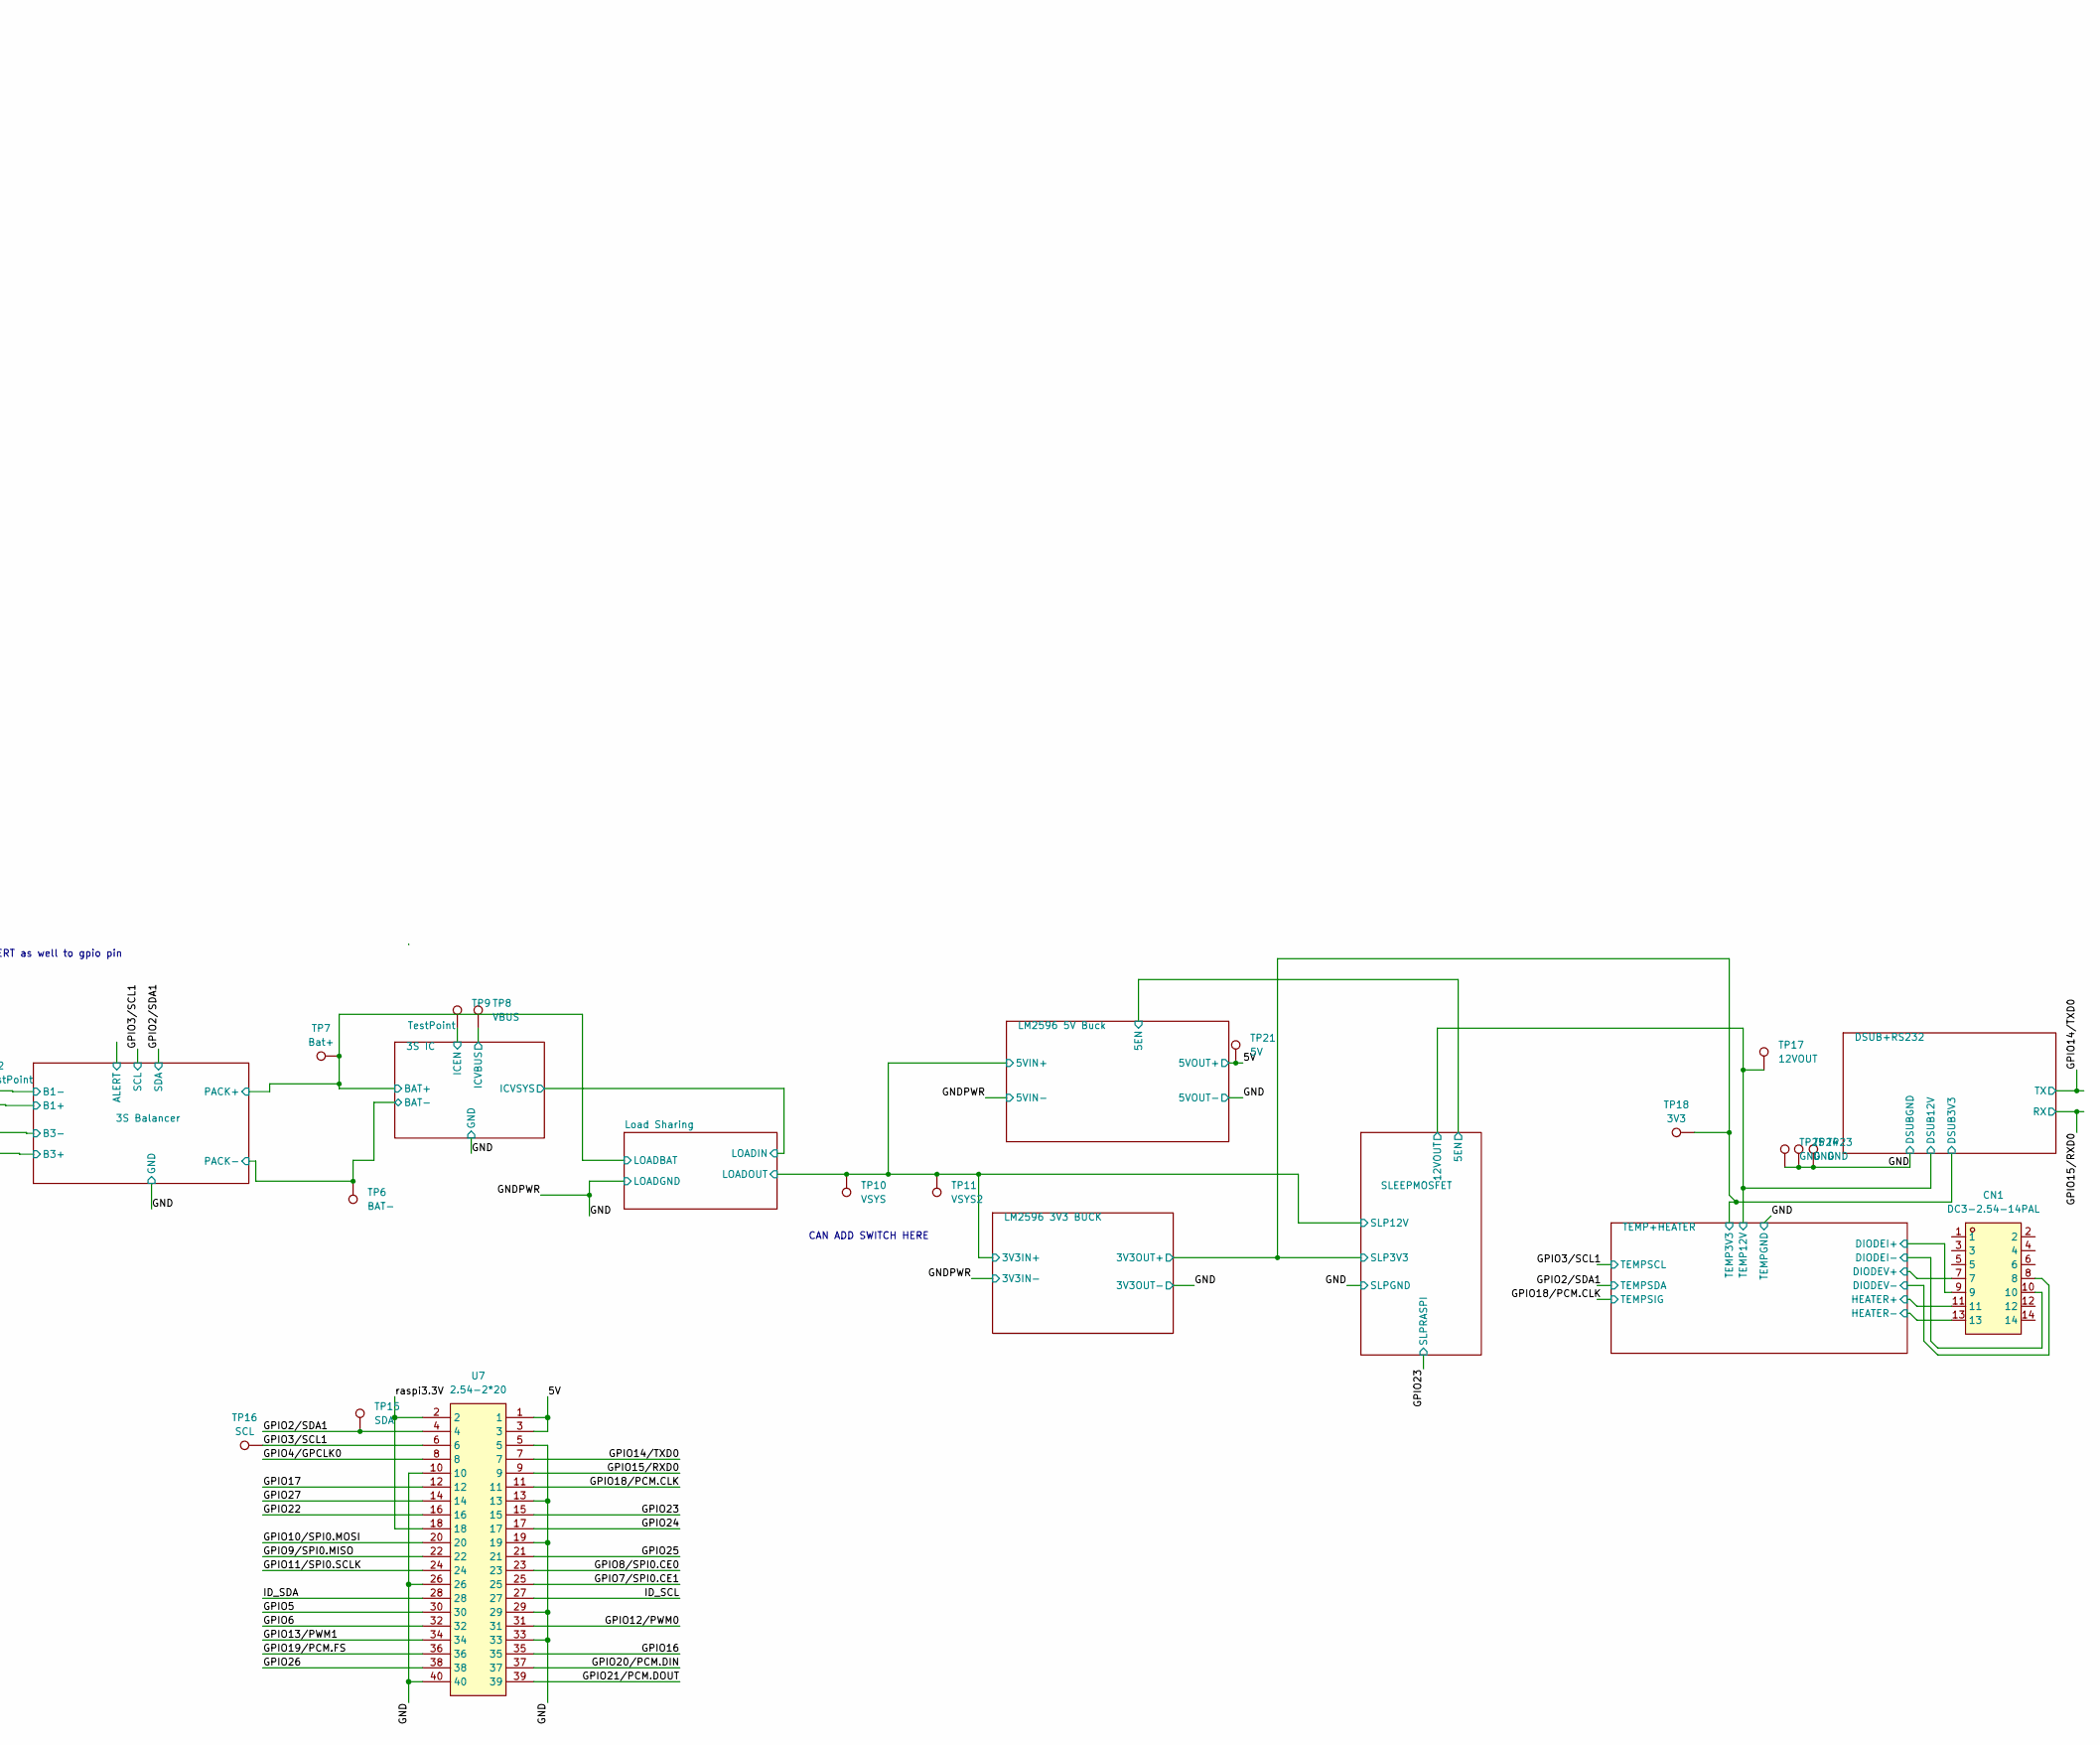
[picture p15: schematic charging-circuit.kicad_sch, part in row 2, column 2]

Parts:
CN1: DC3-2.54-14PAL; IDC-TH_14P-P2.54_ZHOURI_DC3-2.54-14PAL; MPN DC3-2.54-14PAL; LCSC Part C5156673
TP2, TP3, TP4, TP5, TP9: TestPoint; PinHeader_1x01_P2.54mm_Vertical
TP6: BAT-; PinHeader_1x01_P2.54mm_Vertical
TP7: Bat+; PinHeader_1x01_P2.54mm_Vertical
TP8: VBUS; PinHeader_1x01_P2.54mm_Vertical
TP10: VSYS; PinHeader_1x01_P2.54mm_Vertical
TP11: VSYS2; PinHeader_1x01_P2.54mm_Vertical
TP15: SDA; PinHeader_1x01_P2.54mm_Vertical
TP16: SCL; PinHeader_1x01_P2.54mm_Vertical
TP17: 12VOUT; PinHeader_1x01_P2.54mm_Vertical
TP18: 3V3; PinHeader_1x01_P2.54mm_Vertical
TP21: 5V; PinHeader_1x01_P2.54mm_Vertical
TP23, TP24, TP25: GND; PinHeader_1x01_P2.54mm_Vertical
U7: 2.54-2*20; HDR-TH_40P-P2.54-V-F-R2-C20-S2.54; LCSC Part C2977589

Connections:
/3S Balancer/B1+: TP3.1 (1_1); also elsewhere on the board
/3S Balancer/B3-: TP4.1 (1_1); also elsewhere on the board
/3S IC/BAT+: TP5.1 (1_1), TP7.1 (1_1); also elsewhere on the board
/3S IC/ICEN: TP9.1 (1_1); also elsewhere on the board
/3S IC/ICVBUS: TP8.1 (1_1); also elsewhere on the board
/5V: TP21.1 (1_1), U7.1, U7.3; also elsewhere on the board
/DSUB+RS232/DSUB3.3V: CN1.9, TP18.1 (1_1); also elsewhere on the board
/DSUB+RS232/DSUB12V: TP17.1 (1_1); also elsewhere on the board
/GND: CN1.13, TP2.1 (1_1), TP6.1 (1_1), TP23.1 (1_1), TP24.1 (1_1), TP25.1 (1_1), U7.5, U7.10, U7.13, U7.19, U7.26, U7.29, U7.33, U7.40; also elsewhere on the board
/GPIO2/SDA1: TP15.1 (1_1), U7.4; also elsewhere on the board
/GPIO3/SCL1: TP16.1 (1_1), U7.6; also elsewhere on the board
/GPIO4/GPCLK0: U7.8
/GPIO5: U7.30
/GPIO6: U7.32
/GPIO7/SPI0.CE1: U7.25
/GPIO8/SPI0.CE0: U7.23
/GPIO9/SPI0.MISO: U7.22
/GPIO10/SPI0.MOSI: U7.20
/GPIO11/SPI0.SCLK: U7.24
/GPIO12/PWM0: U7.31
/GPIO13/PWM1: U7.34
/GPIO14/TXD0: U7.7; also elsewhere on the board
/GPIO15/RXD0: U7.9; also elsewhere on the board
/GPIO16: U7.35
/GPIO17: U7.12
/GPIO18/PCM.CLK: U7.11; also elsewhere on the board
/GPIO19/PCM.FS: U7.36
/GPIO20/PCM.DIN: U7.37
/GPIO21/PCM.DOUT: U7.39
/GPIO22: U7.16
/GPIO23: U7.15; also elsewhere on the board
/GPIO24: U7.17
/GPIO25: U7.21
/GPIO26: U7.38
/GPIO27: U7.14
/ID_SCL: U7.27
/ID_SDA: U7.28
/LM2596 3V3 BUCK/LM2596_VIN: TP10.1 (1_1), TP11.1 (1_1); also elsewhere on the board
/TEMP+HEATER/A0: CN1.8; also elsewhere on the board
/TEMP+HEATER/A1: CN1.7; also elsewhere on the board
/TEMP+HEATER/DIODEI-: CN1.10; also elsewhere on the board
/TEMP+HEATER/HEATER+: CN1.11; also elsewhere on the board
/raspi3.3V: U7.2, U7.18

Notes on the sheet:
Can connect ALERT as well to gpio pin
CAN ADD SWITCH HERE

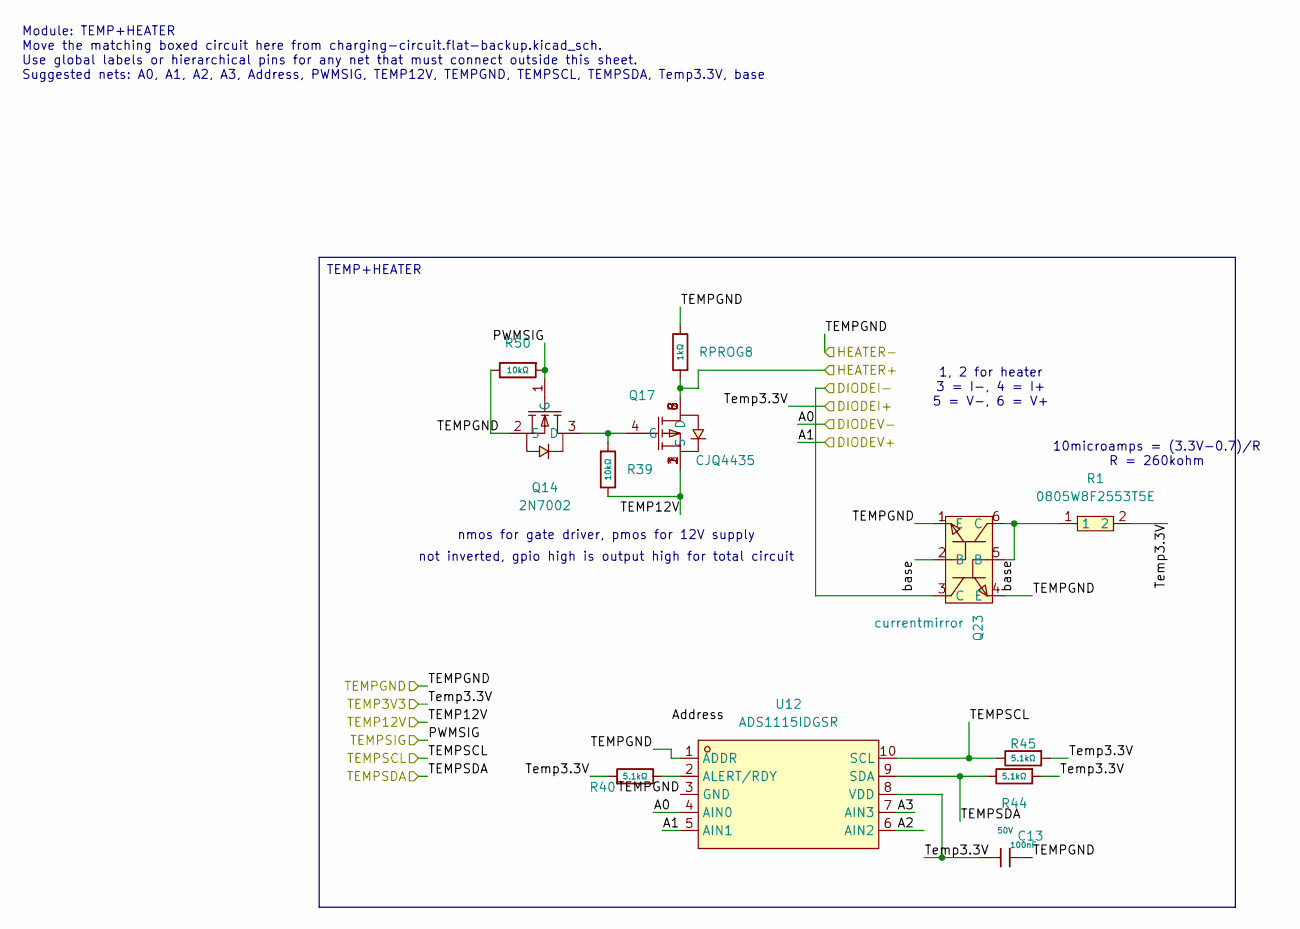
[picture p16: schematic 16_temp_heater.kicad_sch]

Parts:
C13: 100nF; C_0603; Voltage Rated 50V; Tolerance ±10%; Part CC0603KRX7R9BB104; LCSC C14663
Q14: 2N7002; SOT-23-3_L2.9-W1.3-P1.90-LS2.4-BR; LCSC Part C8545
Q17: CJQ4435; SOP-8_L5.0-W4.0-P1.27-LS6.2-BL; LCSC Part C114076
Q23: currentmirror; SOT-363-6_L2.2-W1.3-P0.65-LS2.1-BL; LCSC Part C41375126
R1: 0805W8F2553T5E; R0805; MPN 0805W8F2553T5E; LCSC Part C17578
R39, R50: 10kΩ; R_0603; Overload Voltage (Max) 75V; Tolerance ±1%; Part 0603WAF1002T5E; LCSC C25804
R40, R44, R45: 5.1kΩ; R_0603; Overload Voltage (Max) 75V; Tolerance ±1%; Part 0603WAF5101T5E; LCSC C23186
RPROG8: 1kΩ; R_0603; Overload Voltage (Max) 75V; Tolerance ±1%; Part 0603WAF1001T5E; LCSC C21190
U12: ADS1115IDGSR; MSOP-10_L3.0-W3.0-P0.50-LS5.0-BL; LCSC Part C37593

Connections:
/DSUB+RS232/DSUB3.3V: C13.1, R1.2, R40.1, R44.1, R45.1, U12.8 (VDD); also elsewhere on the board
/DSUB+RS232/DSUB12V: Q17.1 (S), Q17.2 (S), Q17.3 (S), R39.2; also elsewhere on the board
/GND: C13.2, Q14.2 (S), Q23.1 (E), Q23.4 (E), R50.2, RPROG8.2, U12.1 (ADDR), U12.3 (GND); also elsewhere on the board
/GPIO2/SDA1: R44.2, U12.9 (SDA); also elsewhere on the board
/GPIO3/SCL1: R45.2, U12.10 (SCL); also elsewhere on the board
/GPIO18/PCM.CLK: Q14.1 (G), R50.1; also elsewhere on the board
/TEMP+HEATER/A0: U12.4 (AIN0); also elsewhere on the board
/TEMP+HEATER/A1: U12.5 (AIN1); also elsewhere on the board
/TEMP+HEATER/A2: U12.6 (AIN2)
/TEMP+HEATER/A3: U12.7 (AIN3)
/TEMP+HEATER/DIODEI-: Q23.3 (C); also elsewhere on the board
/TEMP+HEATER/HEATER+: Q17.5 (D), Q17.6 (D), Q17.7 (D), Q17.8 (D), RPROG8.1; also elsewhere on the board
/TEMP+HEATER/base: Q23.2 (B), Q23.5 (B), Q23.6 (C), R1.1
unnamed: Q14.3 (D), Q17.4 (G), R39.1
unnamed: R40.2, U12.2 (ALERT/RDY)

Notes on the sheet:
1, 2 for heater 3 = I-, 4 = I+ 5 = V-, 6 = V+
10microamps = (3.3V-0.7)/R R = 260kohm
not inverted, gpio high is output high for total circuit
Module: TEMP+HEATER Move the matching boxed circuit here from charging-circuit.flat-backup.kicad_sch. Use global labels or hierarchical pins for any net that must connect outside this sheet. Suggested nets: A0, A1, A2, A3, Address, PWMSIG, TEMP12V, TEMPGND, TEMPSCL, TEMPSDA, Temp3.3V, base
nmos for gate driver, pmos for 12V supply
TEMP+HEATER

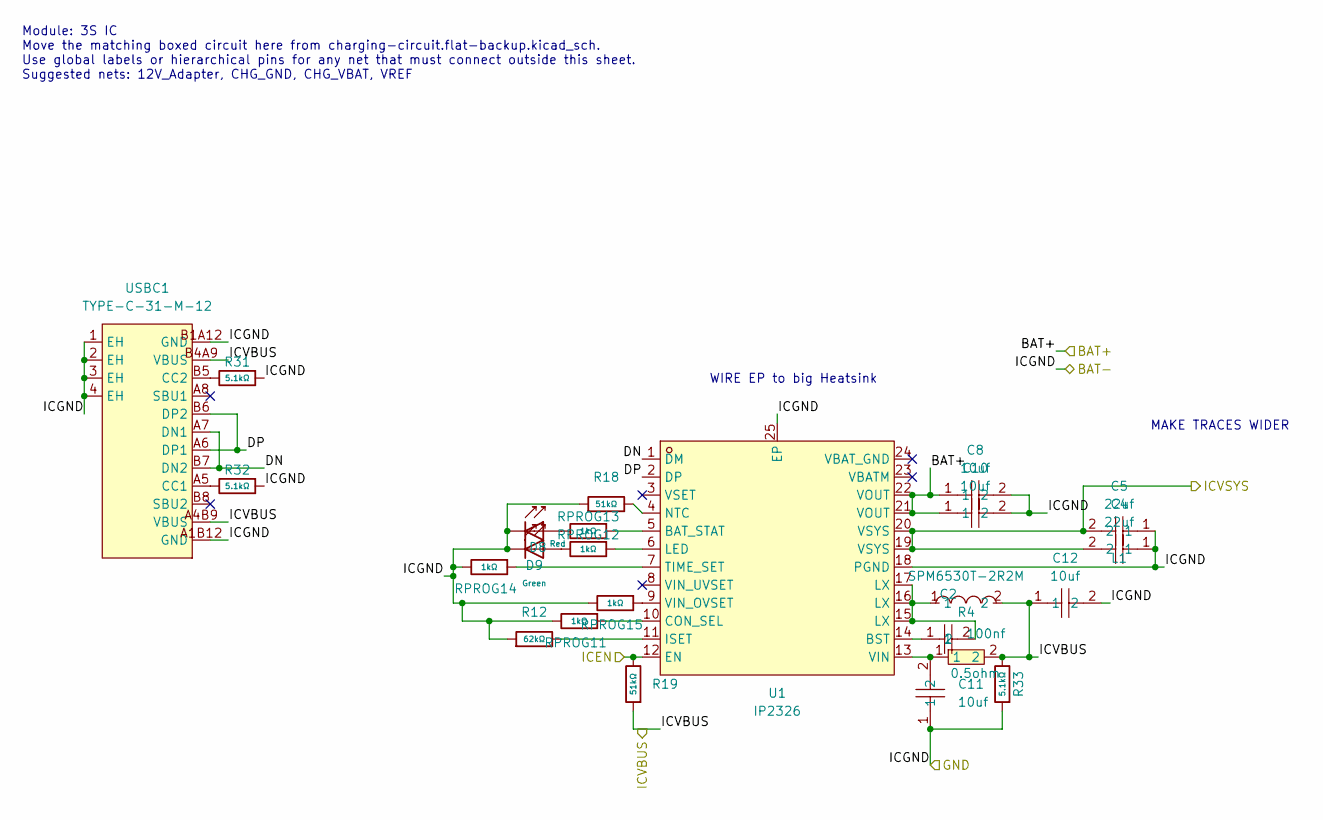
[picture p17: schematic 14_3s_ic.kicad_sch]

Parts:
C2: 100nf; C0805; MPN CL21B104KBCNNNC; LCSC Part C1711
C4, C5: 22uf; C0805; LCSC Part C45783
C8, C10, C11, C12: 10uf; C0805; MPN GRM21BR61E106KA73L; LCSC Part C84416
D8: Red; D_0805; Forward Voltage (VF) 1.6V~2.6V; Part NCD0805R1; LCSC C84256
D9: Green; D_0805; Part KT-0805G; LCSC C2297
L1: SPM6530T-2R2M; IND-SMD_L7.1-W6.5-P5.60; MPN SPM6530T-2R2M; LCSC Part C76855
R4: 0.5ohm; R1206; MPN 1206W4F500LT5E; LCSC Part C25340
R12: 62kΩ; R_0805; Overload Voltage (Max) 150V; Tolerance ±1%; Part 0805W8F6202T5E; LCSC C17783
R18, R19: 51kΩ; R_0805; Overload Voltage (Max) 150V; Tolerance ±1%; Part 0805W8F5102T5E; LCSC C17737
R31, R32, R33: 5.1kΩ; R_0603; Overload Voltage (Max) 75V; Tolerance ±1%; Part 0603WAF5101T5E; LCSC C23186
RPROG11, RPROG12, RPROG13, RPROG14, RPROG15: 1kΩ; R_0603; Overload Voltage (Max) 75V; Tolerance ±1%; Part 0603WAF1001T5E; LCSC C21190
U1: IP2326; VQFN-24_L4.0-W4.0-P0.50-BL-EP2.5; MPN IP2326; LCSC Part C2832094
USBC1: TYPE-C-31-M-12; USB-C_SMD-TYPE-C-31-M-12_1; LCSC Part C165948

Connections:
/3S IC/BAT+: C8.1, C10.1, U1.21 (VOUT), U1.22 (VOUT); also elsewhere on the board
/3S IC/DN: U1.1 (DM), USBC1.A7 (DN1), USBC1.B7 (DN2)
/3S IC/DP: U1.2 (DP), USBC1.A6 (DP1), USBC1.B6 (DP2)
/3S IC/ICEN: R19.2, U1.12 (EN); also elsewhere on the board
/3S IC/ICVBUS: C12.1, L1.2, R4.2, R19.1, R33.2, USBC1.A4B9 (VBUS), USBC1.B4A9 (VBUS); also elsewhere on the board
/GND: C4.1, C5.1, C8.2, C10.2, C11.1, C12.2, D8.1, D9.1, R12.1, R18.1, R31.1, R32.1, R33.1, RPROG11.2, RPROG14.2, RPROG15.2, U1.18 (PGND), U1.25 (EP), USBC1.1 (EH), USBC1.2 (EH), USBC1.3 (EH), USBC1.4 (EH), USBC1.A1B12 (GND), USBC1.B1A12 (GND); also elsewhere on the board
/Load Sharing/VSYS: C4.2, C5.2, U1.19 (VSYS), U1.20 (VSYS); also elsewhere on the board
unnamed: C2.2, L1.1, U1.15 (LX), U1.16 (LX), U1.17 (LX)
unnamed: D8.2, RPROG13.2
unnamed: D9.2, RPROG12.2
unnamed: RPROG13.1, U1.5 (BAT_STAT)
unnamed: C2.1, U1.14 (BST)
unnamed: RPROG11.1, U1.10 (CON_SEL)
unnamed: R12.2, U1.11 (ISET)
unnamed: RPROG12.1, U1.6 (LED)
unnamed: R18.2, U1.4 (NTC)
unnamed: RPROG14.1, U1.7 (TIME_SET)
unnamed: C11.2, R4.1, U1.13 (VIN)
unnamed: RPROG15.1, U1.9 (VIN_OVSET)
unnamed: R32.2, USBC1.A5 (CC1)
unnamed: R31.2, USBC1.B5 (CC2)

Notes on the sheet:
Module: 3S IC Move the matching boxed circuit here from charging-circuit.flat-backup.kicad_sch. Use global labels or hierarchical pins for any net that must connect outside this sheet. Suggested nets: 12V_Adapter, CHG_GND, CHG_VBAT, VREF
WIRE EP to big Heatsink
MAKE TRACES WIDER

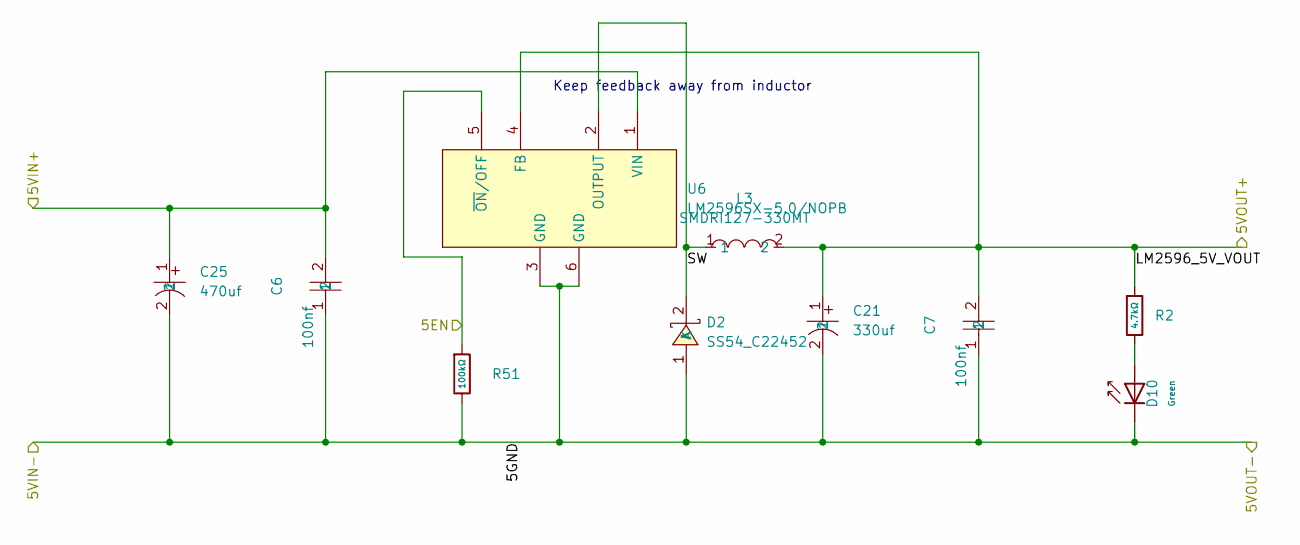
[picture p18: schematic 18_lm2596_5V_buck.kicad_sch, LM2596 Adjustable Buck Module]

Parts:
C6, C7: 100nf; C0805; MPN CL21B104KBCNNNC; LCSC Part C1711
C21: 330uf; CAP-SMD_BD10.0-L10.3-W10.3-FD; MPN RVT1V331M1010; LCSC Part C19606
C25: 470uf; CAP-SMD_BD10.0-L10.3-W10.3-LS11.0-FD; MPN RVT1E471M1010; LCSC Part C3351
D2: SS54_C22452; SMA_L4.4-W2.8-LS5.4-R-RD; MPN SS54; LCSC Part C22452
D10: Green; D_0805; Part KT-0805G; LCSC C2297
L3: SMDRI127-330MT; IND-SMD_L12.3-W12.3; MPN SMDRI127-330MT; LCSC Part C9400
R2: 4.7kΩ; R_0805; Overload Voltage (Max) 150V; Tolerance ±1%; Part 0805W8F4701T5E; LCSC C17673
R51: 100kΩ; R_0603; Overload Voltage (Max) 75V; Tolerance ±1%; Part 0603WAF1003T5E; LCSC C25803
U6: LM2596SX-5.0/NOPB; TO-263-5_L10.2-W8.9-P1.70-TL; MPN LM2596SX-5.0/NOPB; LCSC Part C10002

Connections:
/5V: C7.2, C21.1, L3.2, R2.1, U6.4 (FB); also elsewhere on the board
/GND: C6.1, C7.1, C21.2, C25.2, D2.1 (A), D10.1, R51.2, U6.3 (GND), U6.6 (GND); also elsewhere on the board
/LM2596 3V3 BUCK/LM2596_VIN: C6.2, C25.1, U6.1 (VIN); also elsewhere on the board
/LM2596 5V Buck/SW: D2.2 (K), L3.1, U6.2 (OUTPUT)
/SLEEPMOSFET/5EN: R51.1, U6.5 (~ON/OFF); also elsewhere on the board
unnamed: D10.2, R2.2

Notes on the sheet:
Keep feedback away from inductor

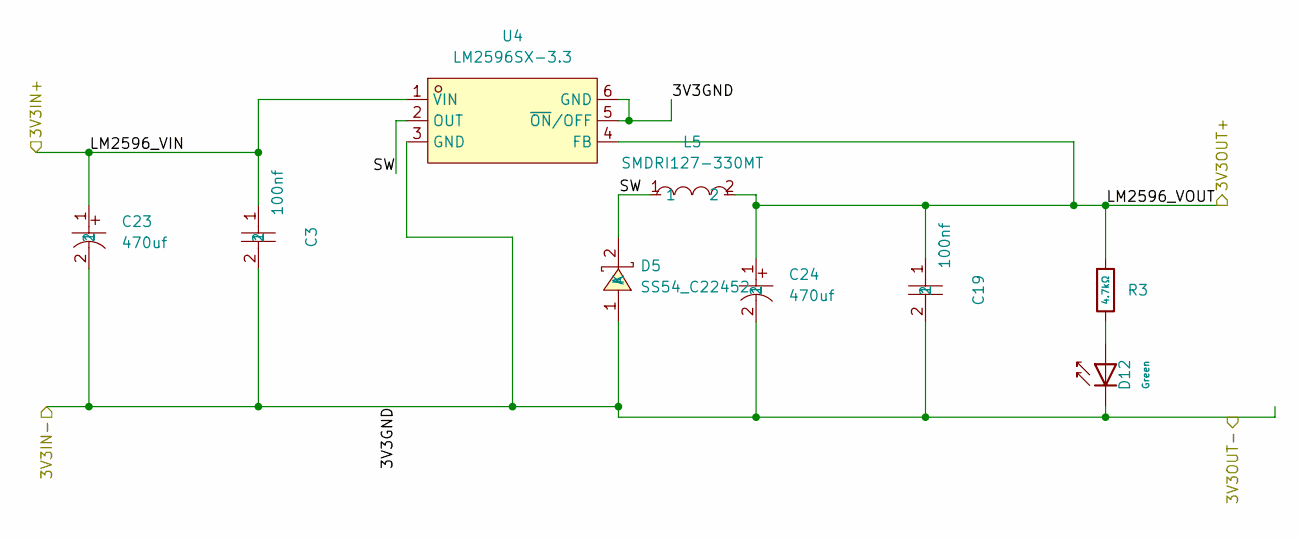
[picture p19: schematic 18_lm2596_adj_buck.kicad_sch, LM2596 Adjustable Buck Module]

Parts:
C3, C19: 100nf; C0805; MPN CL21B104KBCNNNC; LCSC Part C1711
C23, C24: 470uf; CAP-SMD_BD10.0-L10.3-W10.3-LS11.0-FD; MPN RVT1E471M1010; LCSC Part C3351
D5: SS54_C22452; SMA_L4.4-W2.8-LS5.4-R-RD; MPN SS54; LCSC Part C22452
D12: Green; D_0805; Part KT-0805G; LCSC C2297
L5: SMDRI127-330MT; IND-SMD_L12.3-W12.3; MPN SMDRI127-330MT; LCSC Part C9400
R3: 4.7kΩ; R_0805; Overload Voltage (Max) 150V; Tolerance ±1%; Part 0805W8F4701T5E; LCSC C17673
U4: LM2596SX-3.3; TO-263-5_L10.2-W8.6-P1.70-LS14.4-TL; MPN LM2596SX-3.3; LCSC Part C5186052

Connections:
/DSUB+RS232/DSUB3.3V: C19.1, C24.1, L5.2, R3.1, U4.4 (FB); also elsewhere on the board
/GND: C3.2, C19.2, C23.2, C24.2, D5.1 (A), D12.1, U4.3 (GND), U4.5 (~ON/OFF), U4.6 (GND); also elsewhere on the board
/LM2596 3V3 BUCK/LM2596_VIN: C3.1, C23.1, U4.1 (VIN); also elsewhere on the board
/LM2596 3V3 BUCK/SW: D5.2 (K), L5.1, U4.2 (OUT)
unnamed: D12.2, R3.2

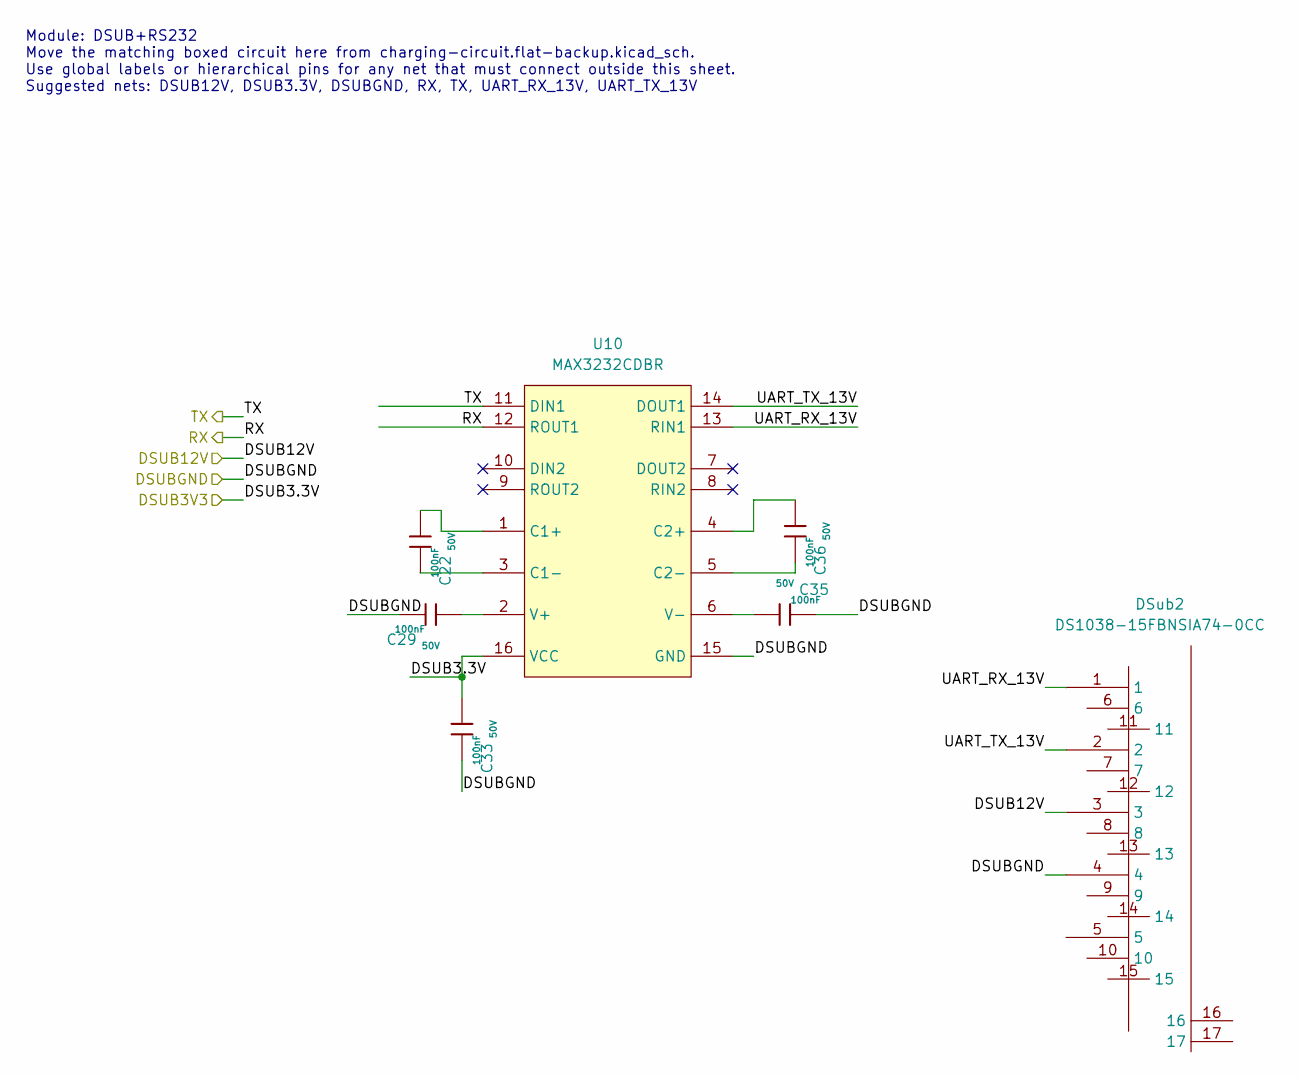
[picture p20: schematic 17_dsub_rs232.kicad_sch]

Parts:
C22, C29, C33, C35, C36: 100nF; C_0603; Voltage Rated 50V; Tolerance ±10%; Part CC0603KRX7R9BB104; LCSC C14663
DSub2: DS1038-15FBNSIA74-0CC; DSUB-TH_DS1038-15FBNSIA74-0CC; LCSC Part C75754
U10: MAX3232CDBR; SSOP-16_L6.2-W5.3-P0.65-LS7.8-BL; LCSC Part C7257

Connections:
/DSUB+RS232/DSUB3.3V: C33.1, U10.16 (VCC); also elsewhere on the board
/DSUB+RS232/DSUB12V: DSub2.3; also elsewhere on the board
/DSUB+RS232/UART_RX_13V: DSub2.1, U10.13 (RIN1)
/DSUB+RS232/UART_TX_13V: DSub2.2, U10.14 (DOUT1)
/GND: C29.2, C33.2, C35.2, DSub2.4, U10.15 (GND); also elsewhere on the board
/GPIO14/TXD0: U10.11 (DIN1); also elsewhere on the board
/GPIO15/RXD0: U10.12 (ROUT1); also elsewhere on the board
unnamed: C22.1, U10.1 (C1+)
unnamed: C22.2, U10.3 (C1-)
unnamed: C36.1, U10.4 (C2+)
unnamed: C36.2, U10.5 (C2-)
unnamed: C29.1, U10.2 (V+)
unnamed: C35.1, U10.6 (V-)

Notes on the sheet:
Module: DSUB+RS232 Move the matching boxed circuit here from charging-circuit.flat-backup.kicad_sch. Use global labels or hierarchical pins for any net that must connect outside this sheet. Suggested nets: DSUB12V, DSUB3.3V, DSUBGND, RX, TX, UART_RX_13V, UART_TX_13V

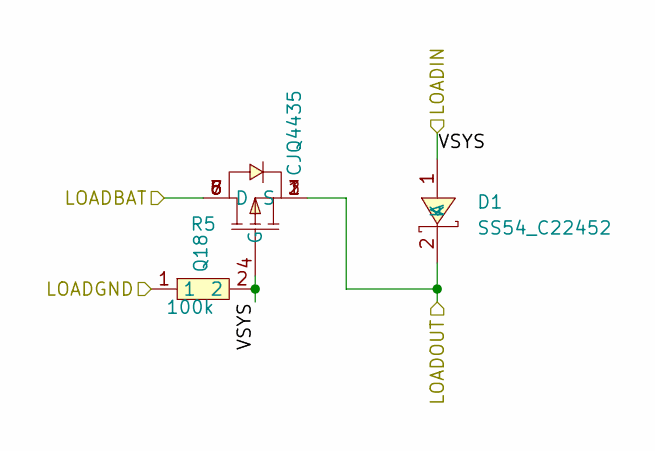
[picture p21: schematic loadshare.kicad_sch]

Parts:
D1: SS54_C22452; SMA_L4.4-W2.8-LS5.4-R-RD; MPN SS54; LCSC Part C22452
Q18: CJQ4435; SOP-8_L5.0-W4.0-P1.27-LS6.2-BL; LCSC Part C114076
R5: 100k; R0805; MPN 0805W8J0104T5E; LCSC Part C25611

Connections:
/3S IC/BAT+: Q18.5 (D), Q18.6 (D), Q18.7 (D), Q18.8 (D); also elsewhere on the board
/GND: R5.1; also elsewhere on the board
/LM2596 3V3 BUCK/LM2596_VIN: D1.2 (K), Q18.1 (S), Q18.2 (S), Q18.3 (S); also elsewhere on the board
/Load Sharing/VSYS: D1.1 (A), Q18.4 (G), R5.2; also elsewhere on the board
