vacuumsens/Final/PCB/charging-circuit/charging-circuit.kicad_pcb

## KiCad design PCB/charging-circuit/charging-circuit.kicad_pcb (continued)

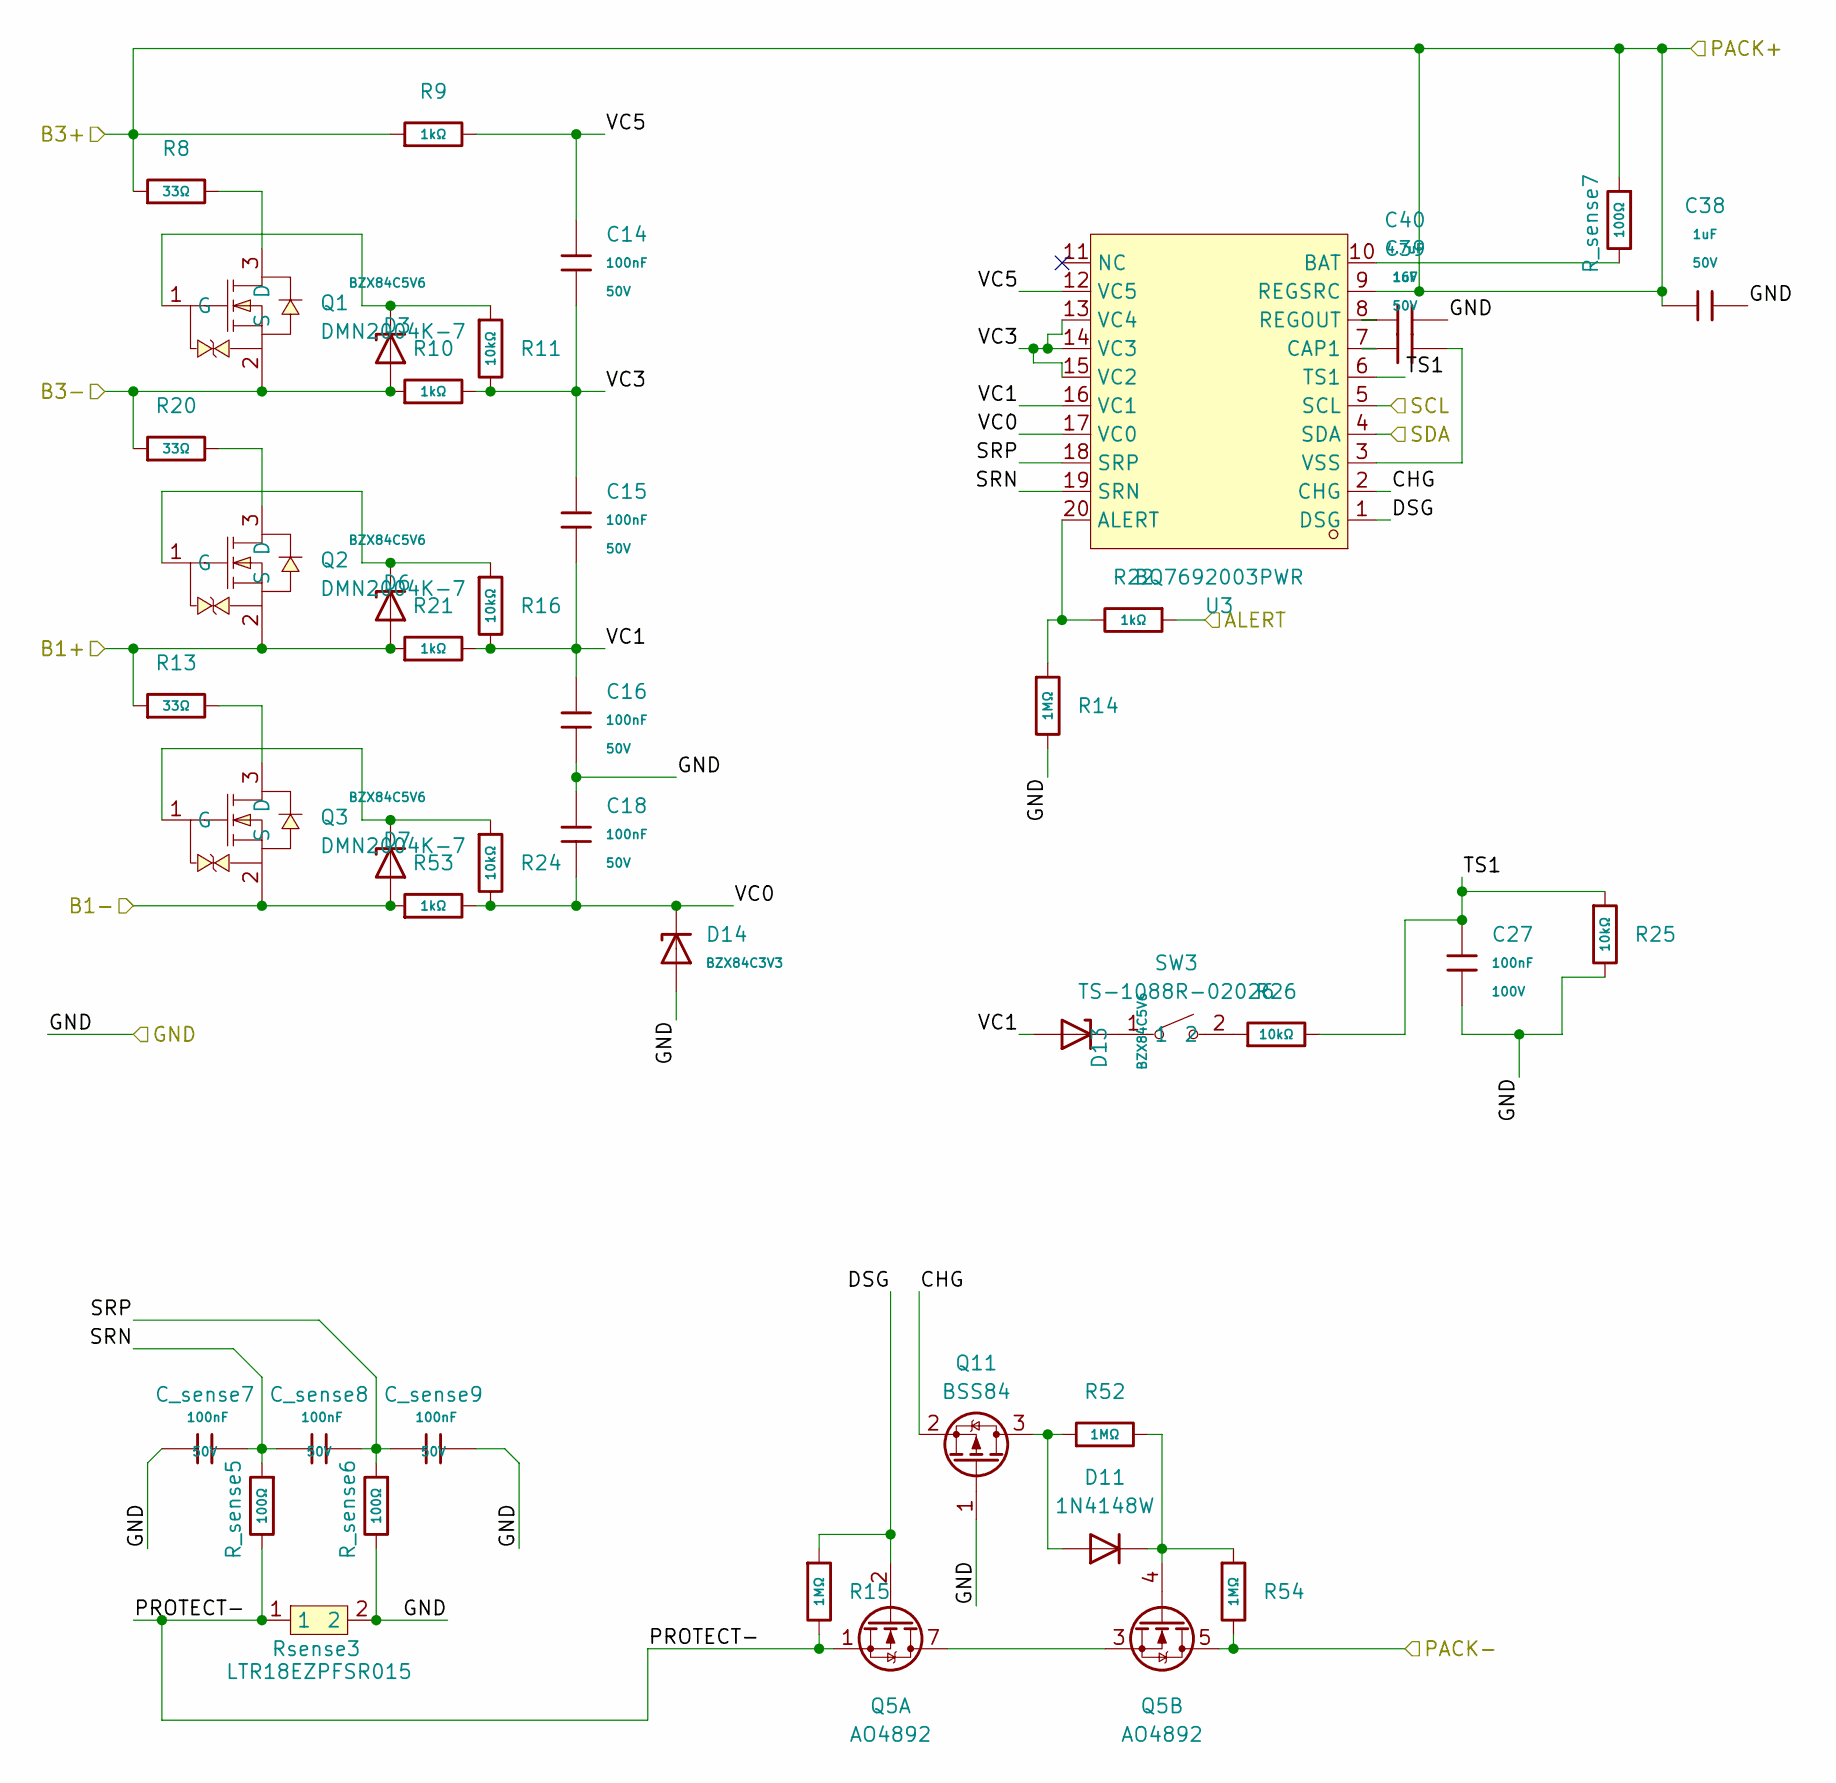
[picture p22: schematic 15_3s_balancer.kicad_sch]

Parts:
C14, C15, C16, C18: 100nF; C_0603; Voltage Rated 50V; Tolerance ±10%; Part CC0603KRX7R9BB104; LCSC C14663
C27: 100nF; C_0805; Voltage Rated 100V; Tolerance ±10%; Part CL21B104KCFNNNE; LCSC C28233
C38, C39: 1uF; C_0603; Voltage Rated 50V; Tolerance ±10%; Part CL10A105KB8NNNC; LCSC C15849
C40: 4.7uF; C_0603; Voltage Rated 16V; Tolerance ±10%; Part CL10A475KO8NNNC; LCSC C19666
C_sense7, C_sense8, C_sense9: 100nF; C_0603; Voltage Rated 50V; Tolerance ±10%; Part CC0603KRX7R9BB104; LCSC C14663
D3, D6, D7, D13: BZX84C5V6; D_SOT-23; Part BZX84C5V6; LCSC C19077469
D11: 1N4148W; D_SOD-123
D14: BZX84C3V3; D_SOT-23; Zener Voltage (Range) 3.1V~3.5V; Zener Voltage (Nom) 3.3V; Part BZX84C3V3; LCSC C19077467
Q1, Q2, Q3: DMN2004K-7; SOT-23-3_L3.0-W1.7-P0.95-LS2.9-BR; MPN DMN2004K-7; LCSC Part C75285
Q5: AO4892; SOIC-8_3.9x4.9mm_P1.27mm; LCSC Part C357830
Q11: BSS84; SOT-23; LCSC Part C82079
R8, R13, R20: 33Ω; R_0805; Overload Voltage (Max) 150V; Tolerance ±1%; Part 0805W8F330JT5E; LCSC C17634
R9, R10, R21, R22, R53: 1kΩ; R_0805; Overload Voltage (Max) 150V; Tolerance ±1%; Part 0805W8F1001T5E; LCSC C17513
R11, R16, R24, R25, R26: 10kΩ; R_0805; Overload Voltage (Max) 150V; Tolerance ±1%; Part 0805W8F1002T5E; LCSC C17414
R14: 1MΩ; R_0805; Overload Voltage (Max) 150V; Tolerance ±1%; Part 0805W8F1004T5E; LCSC C17514
R15, R52, R54: 1MΩ; R_0603; Overload Voltage (Max) 75V; Tolerance ±1%; Part 0603WAF1004T5E; LCSC C22935
R_sense5, R_sense6, R_sense7: 100Ω; R_0603; Overload Voltage (Max) 75V; Tolerance ±1%; Part 0603WAF1000T5E; LCSC C22775
Rsense3: LTR18EZPFSR015; R0612; LCSC Part C510175
SW3: TS-1088R-02026; SW-SMD_L3.9-W3.0-P4.45; LCSC Part C455280
U3: BQ7692003PWR; TSSOP-20_L6.5-W4.4-P0.65-LS6.4-BL; MPN BQ7692003PWR; LCSC Part C601650

Connections:
/3S Balancer/ALERT: R22.1
/3S Balancer/B1+: D6.1, Q2.2 (S), R13.1, R21.1; also elsewhere on the board
/3S Balancer/B3-: D3.1, Q1.2 (S), R10.1, R20.1; also elsewhere on the board
/3S Balancer/CHG: Q11.2 (S), U3.2 (CHG)
/3S Balancer/DSG: Q5.2 (G1), R15.1, U3.1 (DSG)
/3S Balancer/PROTECT-: Q5.1 (S1), R15.2, R_sense5.2, Rsense3.1
/3S Balancer/SRN: C_sense7.2, C_sense8.1, R_sense5.1, U3.19 (SRN)
/3S Balancer/SRP: C_sense8.2, C_sense9.1, R_sense6.1, U3.18 (SRP)
/3S Balancer/TS1: C27.1, R25.1, R26.2, U3.6 (TS1)
/3S Balancer/VC0: C18.2, D14.3, R24.2, R53.2, U3.17 (VC0)
/3S Balancer/VC1: C15.2, C16.1, D13.1, R16.2, R21.2, U3.16 (VC1)
/3S Balancer/VC3: C14.2, C15.1, R10.2, R11.2, U3.13 (VC4), U3.14 (VC3), U3.15 (VC2)
/3S Balancer/VC5: C14.1, R9.2, U3.12 (VC5)
/3S IC/BAT+: C38.1, R8.1, R9.1, R_sense7.1, U3.9 (REGSRC); also elsewhere on the board
/GND: C16.2, C18.1, C27.2, C38.2, C40.2, C_sense7.1, C_sense9.2, D7.1, D14.1, Q3.2 (S), Q5.5 (D2), Q5.6 (D2), Q11.1 (G), R14.2, R25.2, R53.1, R54.2, R_sense6.2, Rsense3.2; also elsewhere on the board
/GPIO2/SDA1: U3.4 (SDA); also elsewhere on the board
/GPIO3/SCL1: U3.5 (SCL); also elsewhere on the board
unnamed: D11.2 (A), Q11.3 (D), R52.1
unnamed: D11.1 (K), Q5.4 (G2), R52.2, R54.1
unnamed: D13.3, SW3.1
unnamed: Q1.3 (D), R8.2
unnamed: D3.3, Q1.1 (G), R11.1
unnamed: Q2.3 (D), R20.2
unnamed: D6.3, Q2.1 (G), R16.1
unnamed: Q3.3 (D), R13.2
unnamed: D7.3, Q3.1 (G), R24.1
unnamed: Q5.3 (S2), Q5.7 (D1), Q5.8 (D1)
unnamed: R26.1, SW3.2
unnamed: R14.1, R22.2, U3.20 (ALERT)
unnamed: R_sense7.2, U3.10 (BAT)
unnamed: C39.1, U3.7 (CAP1)
unnamed: C40.1, U3.8 (REGOUT)
unnamed: C39.2, U3.3 (VSS)

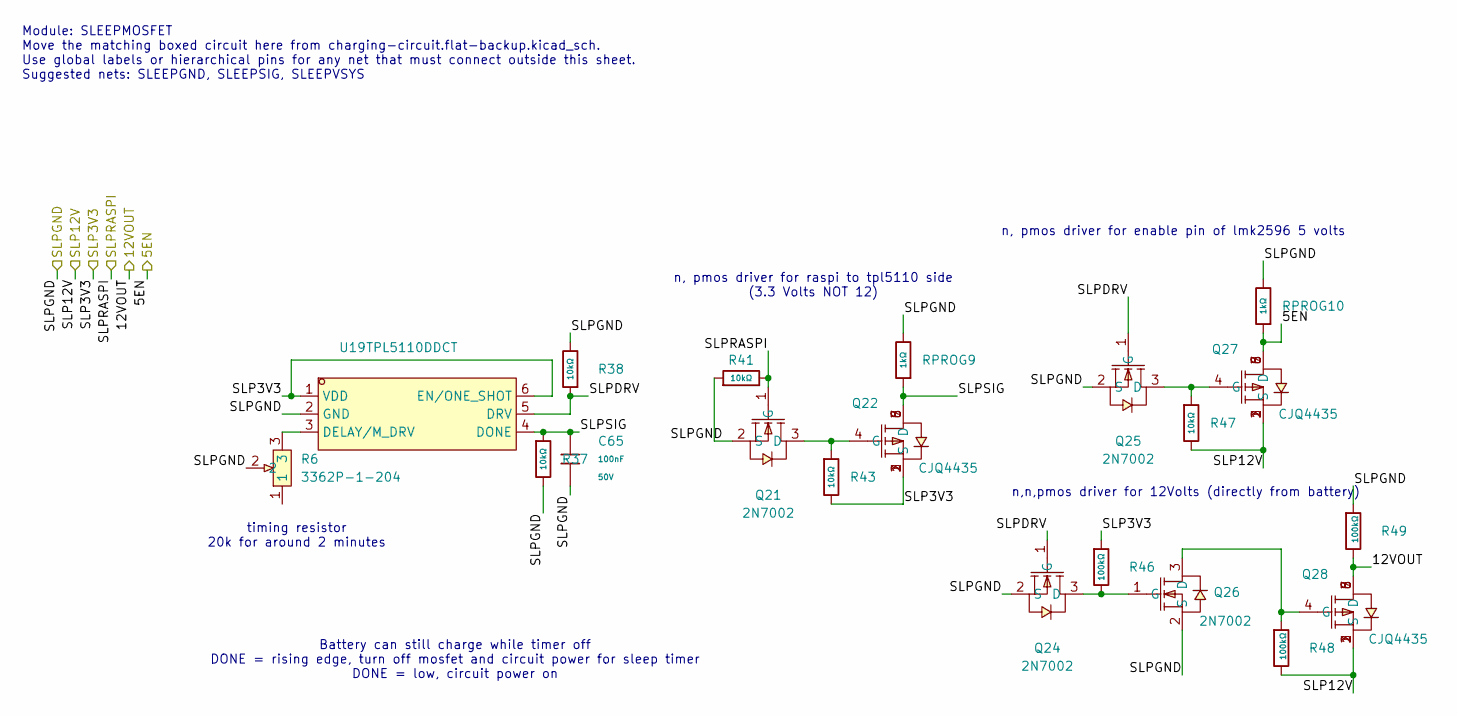
[picture p23: schematic 04_sleepmosfet.kicad_sch]

Parts:
C65: 100nF; C_0603; Voltage Rated 50V; Tolerance ±10%; Part CC0603KRX7R9BB104; LCSC C14663
Q21, Q24, Q25, Q26: 2N7002; SOT-23-3_L2.9-W1.3-P1.90-LS2.4-BR; LCSC Part C8545
Q22, Q27, Q28: CJQ4435; SOP-8_L5.0-W4.0-P1.27-LS6.2-BL; LCSC Part C114076
R6: 3362P-1-204; RES-ADJ-TH_3P-L7.1-W6.9-P2.50-L_3362P; MPN 3362P-1-204; LCSC Part C118941
R37, R38, R41, R43, R47: 10kΩ; R_0603; Overload Voltage (Max) 75V; Tolerance ±1%; Part 0603WAF1002T5E; LCSC C25804
R46, R48, R49: 100kΩ; R_0603; Overload Voltage (Max) 75V; Tolerance ±1%; Part 0603WAF1003T5E; LCSC C25803
RPROG9, RPROG10: 1kΩ; R_0603; Overload Voltage (Max) 75V; Tolerance ±1%; Part 0603WAF1001T5E; LCSC C21190
U19: TPL5110DDCT; TSOT-23-6_L2.9-W1.6-P0.95-LS2.8-BR; LCSC Part C125830

Connections:
/DSUB+RS232/DSUB3.3V: Q22.1 (S), Q22.2 (S), Q22.3 (S), R43.2, R46.1, U19.1 (VDD), U19.6 (EN/ONE_SHOT); also elsewhere on the board
/DSUB+RS232/DSUB12V: Q28.5 (D), Q28.6 (D), Q28.7 (D), Q28.8 (D), R49.2; also elsewhere on the board
/GND: C65.2, Q21.2 (S), Q24.2 (S), Q25.2 (S), Q26.2 (S), R6.2, R37.2, R38.2, R41.1, R49.1, RPROG9.2, RPROG10.2, U19.2 (GND); also elsewhere on the board
/GPIO23: Q21.1 (G), R41.2; also elsewhere on the board
/LM2596 3V3 BUCK/LM2596_VIN: Q27.1 (S), Q27.2 (S), Q27.3 (S), Q28.1 (S), Q28.2 (S), Q28.3 (S), R47.2, R48.2; also elsewhere on the board
/SLEEPMOSFET/5EN: Q27.5 (D), Q27.6 (D), Q27.7 (D), Q27.8 (D), RPROG10.1; also elsewhere on the board
/SLEEPMOSFET/SLPDRV: Q24.1 (G), Q25.1 (G), R38.1, U19.5 (DRV)
/SLEEPMOSFET/SLPSIG: C65.1, Q22.5 (D), Q22.6 (D), Q22.7 (D), Q22.8 (D), R37.1, RPROG9.1, U19.4 (DONE)
unnamed: Q21.3 (D), Q22.4 (G), R43.1
unnamed: Q24.3 (D), Q26.1 (G), R46.2
unnamed: Q25.3 (D), Q27.4 (G), R47.1
unnamed: Q26.3 (D), Q28.4 (G), R48.1
unnamed: R6.3, U19.3 (DELAY/M_DRV)

Notes on the sheet:
n, pmos driver for enable pin of lmk2596 5 volts
Battery can still charge while timer off DONE = rising edge, turn off mosfet and circuit power for sleep timer DONE = low, circuit power on
timing resistor 20k for around 2 minutes
Module: SLEEPMOSFET Move the matching boxed circuit here from charging-circuit.flat-backup.kicad_sch. Use global labels or hierarchical pins for any net that must connect outside this sheet. Suggested nets: SLEEPGND, SLEEPSIG, SLEEPVSYS
n, pmos driver for raspi to tpl5110 side (3.3 Volts NOT 12)
n,n,pmos driver for 12Volts (directly from battery)

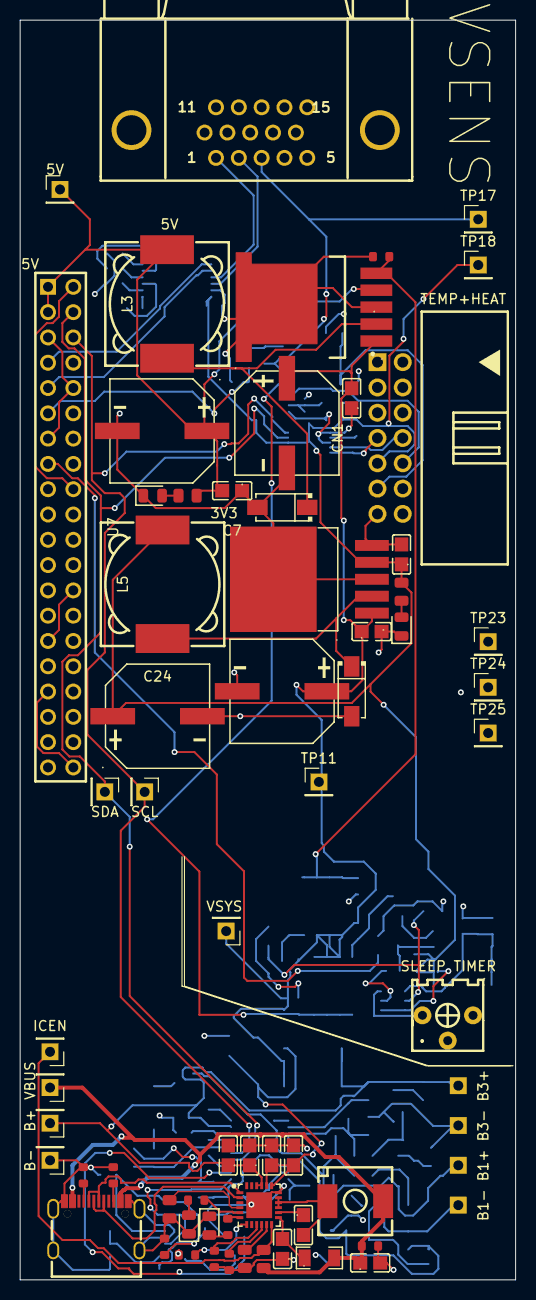
[picture p24: board charging-circuit.kicad_pcb from above]

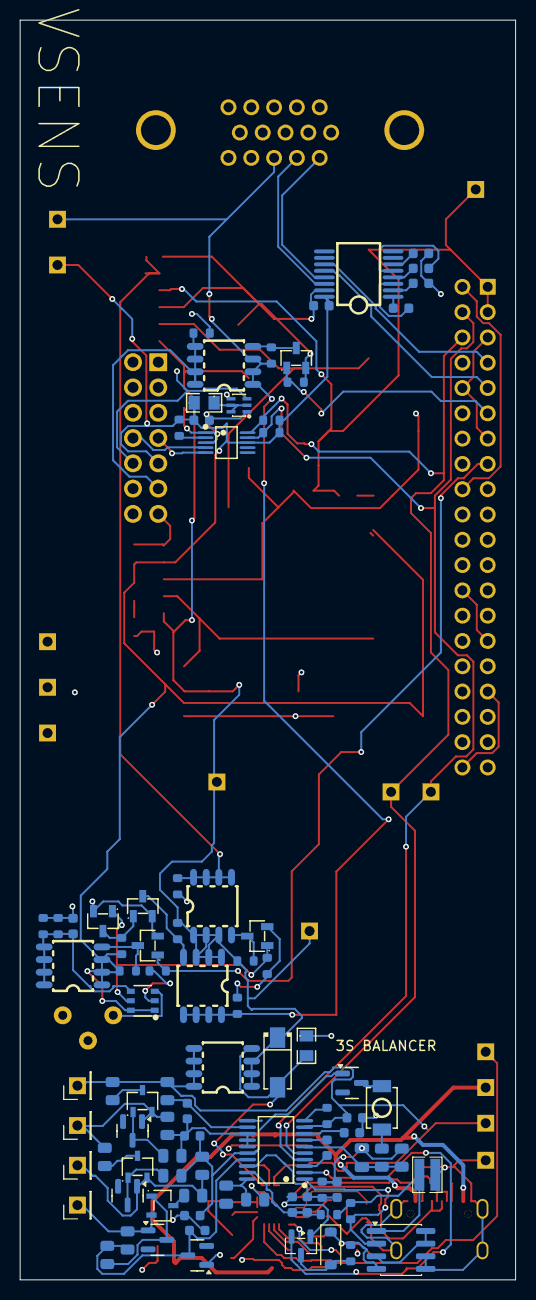
[picture p25: board charging-circuit.kicad_pcb from below]

Board: 4 copper layers, 49.8 x 126.5 mm, 150 parts (88 on the bottom side), 87 nets.
