vacuumsens/Final/PCB/charging-circuit/temporarycircuit.kicad_pcb

## KiCad design PCB/charging-circuit/temporarycircuit.kicad_pcb (2026-06-02)

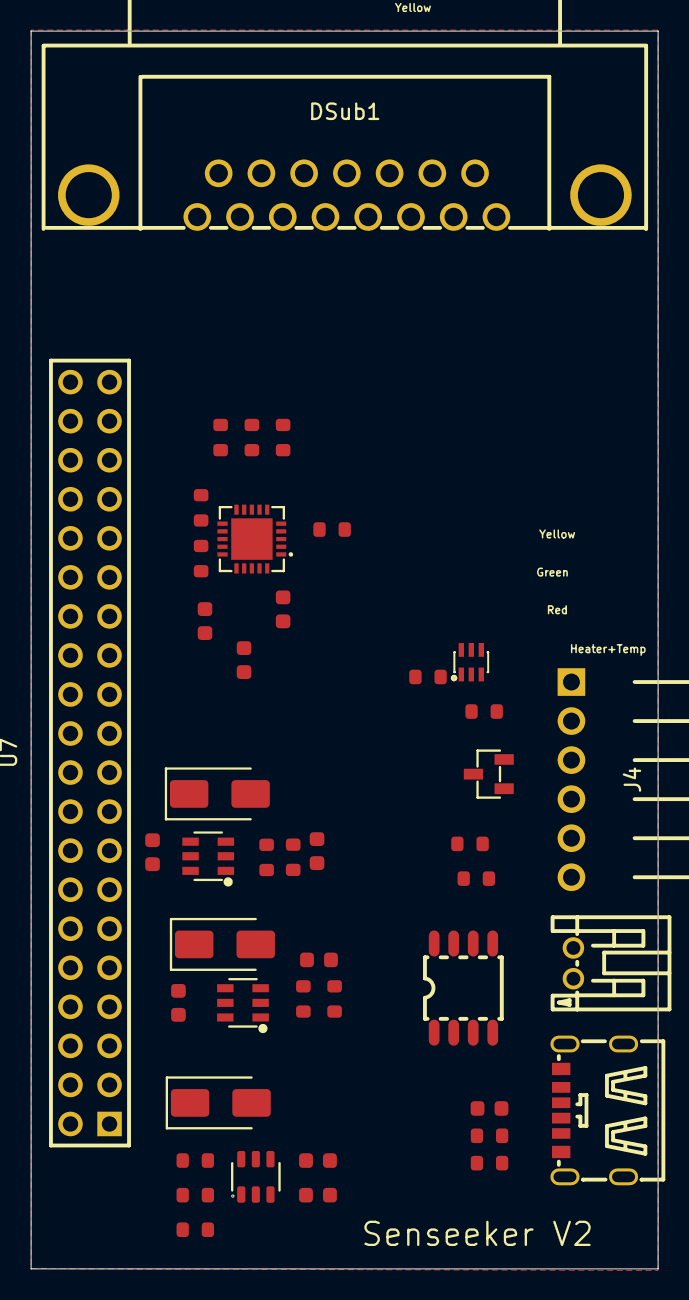
[picture p26: board temporarycircuit.kicad_pcb from above]

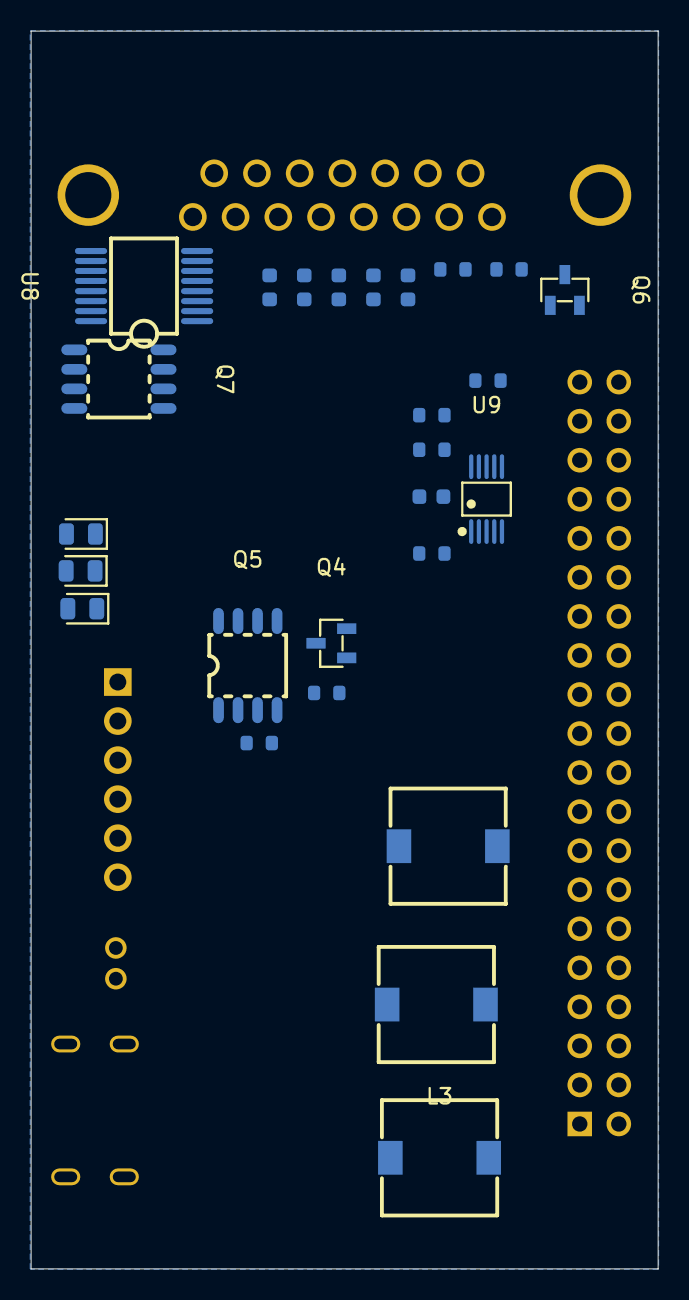
[picture p27: board temporarycircuit.kicad_pcb from below]

Board: 2 copper layers, 40.8 x 80.5 mm, 70 parts (26 on the bottom side), 53 nets, no tracks yet.

Parts:
C1, C6: 4.7uF; C_0603
C2, C12, C17, C18, C19, C20, C21: 100nF; C_0603
C3, C4, C5, C7, C10, C11: 22uF; C_0603
C8: 10uF; C_0603
D1: Red; D_0805
D2: Yellow; D_0805
D3: Green; D_0805
D4, D5, D6: SS34; D_SMA
DSub1: DS1037-15FNAKT74-0CC; DSUB-TH_DS1037-15FNAKT74-0CC
J1: USB_C_Receptacle_PowerOnly_6P; TYPE-C-SMD_TYPE-C-6P
J4: Heater+TempPins; HDR-TH_6P-P2.54-H-M-W10.0
L1, L2, L3: 22uH; IND-SMD_L7.5-W7.5
Q1, Q4, Q6: 2N7002; SOT-23-3_L2.9-W1.3-P1.90-LS2.4-BR
Q2, Q5, Q7: CJQ4435; SOP-8_L5.0-W4.0-P1.27-LS6.2-BL
Q3: currentmirror; SOT-363-6_L2.2-W1.3-P0.65-LS2.1-BL
R1, R2, R12, R13, R21: 5.1kΩ; R_0603
R3: 3kΩ; R_0603
R4: 20kΩ; R_0603
R5, R14, R15, R16: 10kΩ; R_0603
R6, R7, R11: 470Ω; R_0603
R8: 91kΩ; R_0603
R9: 4.7kΩ; R_0603
R10: 22kΩ; R_0603
R18: 6.8kΩ; R_0603
R19: 2kΩ; R_0603
R20: 2.2kΩ; R_0603
R22: 100Ω; R_0603
R23: 240kΩ; R_0603
RPROG1, RPROG4, RPROG5, RPROG6: 1kΩ; R_0603
RPROG3: 10kΩ; R_0603
U2, U3, U6: MT3608; SOT-23-6_L2.9-W1.6-P0.95-LS2.8-BL
U4: MCP73871; QFN-20_L4.0-W4.0-P0.5-BL-EP
U5: Battery Input; CONN-TH_S2B-PH-K-S-GW
U7: 2.54-2*20; HDR-TH_40P-P2.54-V-F-R2-C20-S2.54
U8: MAX3232CDBR; SSOP-16_L6.2-W5.3-P0.65-LS7.8-BL
U9: ADS1115IDGSR; MSOP-10_L3.0-W3.0-P0.50-LS5.0-BL

Connections:
/3.3V: C11.2, C21.1, D6.1, Q5.1 (S), Q5.2 (S), Q5.3 (S), R16.2, R18.1, U8.16 (VCC)
/5 Vout: C4.2, D5.1, R10.1, U7.2, U7.4
/12V: C3.2, D4.1, Q2.1 (S), Q2.2 (S), Q2.3 (S), Q7.1 (S), Q7.2 (S), Q7.3 (S), R8.1, R14.2, R15.2
/A0: J4.5, U9.4 (AIN0)
/A1: J4.6, U9.5 (AIN1)
/Address: R22.2, U9.1 (ADDR)
/GPIO3/SCL1: R12.2, R21.2, U7.5, U9.9 (SDA), U9.10 (SCL)
/GPIO14/TXD0: U7.8, U8.11 (DIN1)
/GPIO15/RXD0: U7.10, U8.12 (ROUT1)
/GPIO18/PCM.CLK: Q1.1 (G), U7.12
/GPIO23: Q6.1 (G), U7.16
/GPIO24: Q4.1 (G), U7.18
/Temp3.3V: C12.1, J4.4, Q5.5 (D), Q5.6 (D), Q5.7 (D), Q5.8 (D), R4.1, R12.1, R13.1, R21.1, RPROG4.1, U9.8 (VDD)
/UART_RX_13V: DSub1.1, U8.13 (RIN1)
/UART_TX_13V: DSub1.2, U8.14 (DOUT1)
/VSYS: C5.1, C6.2, C7.1, C10.1, L1.1, L2.1, L3.1, U2.4 (EN), U2.5 (IN), U3.4 (EN), U3.5 (IN), U4.1 (OUT), U4.20 (OUT), U6.4 (EN), U6.5 (IN)
/base: Q3.2 (B), Q3.5 (B), Q3.6 (C), R23.2
/raspi3.3V: U7.1, U7.17
GND: C1.1, C2.2, C3.1, C4.1, C5.2, C6.1, C7.2, C8.1, C10.2, C11.1, C12.2, C17.2, C18.2, C21.2, DSub1.4, J1.A12 (GND), J1.B12 (GND), J1.S1 (SHIELD), J4.1, Q1.2 (S), Q3.1 (E), Q3.4 (E), Q4.2 (S), Q6.2 (S), R1.2, R2.2, R3.2, R5.2, R9.2, R19.2, R22.1, RPROG1.1, RPROG3.2, RPROG4.2, RPROG5.2, RPROG6.2, U2.2 (GND), U3.2 (GND), U4.10 (V_{SS}), U4.11 (V_{SS}), U4.21 (V_{SS}), U5.2, U6.2 (GND), U7.6, U7.9, U7.14, U7.20, U7.25, U7.30, U7.34, U7.39, U8.15 (GND), U9.3 (GND)
unnamed: D1.1, R7.1
unnamed: D2.1, R11.1
unnamed: D3.1, R6.1
unnamed: DSub1.3, Q7.5 (D), Q7.6 (D), Q7.7 (D), Q7.8 (D), RPROG6.1
unnamed: J1.A5 (CC1), R1.1
unnamed: J1.B5 (CC2), R2.1
unnamed: J4.2, Q2.5 (D), Q2.6 (D), Q2.7 (D), Q2.8 (D), RPROG5.1
unnamed: J4.3, Q3.3 (C)
unnamed: Q1.3 (D), Q2.4 (G), R14.1
unnamed: Q4.3 (D), Q5.4 (G), R16.1
unnamed: Q6.3 (D), Q7.4 (G), R15.1
unnamed: R18.2, R20.1
unnamed: R4.2, R23.1
unnamed: R3.1, R10.2, U2.3 (FB)
unnamed: D5.2, L1.2, U2.1 (SW)
unnamed: R8.2, R9.1, U3.3 (FB)
unnamed: D4.2, L2.2, U3.1 (SW)
unnamed: RPROG1.2, U4.13 (PROG1)
unnamed: RPROG3.1, U4.12 (PROG3)
unnamed: R7.2, U4.8 (STAT1/~LBO)
unnamed: R6.2, U4.7 (STAT2)
unnamed: R5.1, U4.5 (THERM)
unnamed: C1.2, U4.14 (V_{BAT}), U4.15 (V_{BAT}), U4.16 (V_{BAT_SENSE}), U5.1
unnamed: R11.2, U4.6 (~PG)
unnamed: R19.1, R20.2, U6.3 (FB)
unnamed: D6.2, L3.2, U6.1 (SW)
unnamed: C20.1, U8.1 (C1+)
unnamed: C20.2, U8.3 (C1-)
unnamed: C19.1, U8.4 (C2+)
unnamed: C19.2, U8.5 (C2-)
unnamed: C18.1, U8.2 (V+)
unnamed: C17.1, U8.6 (V-)
unnamed: R13.2, U9.2 (ALERT/RDY)
VBUS: C2.1, C8.2, D1.2, D2.2, D3.2, J1.A9 (VBUS), J1.B9 (VBUS), U4.2 (VPCC), U4.3 (SEL), U4.4 (PROG2), U4.9 (~TE), U4.17 (CE), U4.18 (IN), U4.19 (IN)
